vsdip/avsddac_3v3_sky130_v2/README.md

# 10Bit_potentiometric_DAC

This repository presents the design of a 10 Bit Potentiometric Digital to Analog Converter with 3.3V analog voltage, 1.8V digital voltage and 1 off-chip external reference using the sky130 technology.The specifications of the design can be found [here](https://github.com/neethujohny/avsddac_3v3/files/5164067/pdac_IP.pdf).

## Table of Contents ##

- [1. Introduction](#introduction)
- [2. Pre Layout Simulations](#pre-layout-simulations)
  * [Switch](#switch)
  * [2 bit DAC](#2-bit-dac)
  * [3 bit DAC](#3-bit-dac)
  * [4 bit DAC](#4-bit-dac)
  * [5 bit DAC](#5-bit-dac)
  * [6 bit DAC](#6-bit-dac)
  * [7 bit DAC](#7-bit-dac)
  * [8 bit DAC](#8-bit-dac)
  * [9 bit DAC](#9-bit-dac)
  * [10 bit DAC](#10-bit-dac)
- [3. Observation](#observation)
- [4. Steps to install the tools and execute the pre layout design](#steps-to-install-the-tools-and-execute-the-pre-layout-design) 
- [5. Layout](#layout)
  * [2bit DAC](#2bit-dac)
  * [3bit DAC](#3bit-dac)
  * [4bit DAC](#4bit-dac)
  * [5bit DAC](#5bit-dac)
  * [6bit DAC](#6bit-dac)
  * [7bit DAC](#7bit-dac)
  * [8bit DAC](#8bit-dac)
  * [9bit DAC](#9bit-dac)
  * [10bit DAC](#10bit-dac)
- [6. Executing the postlayout design simulations](#executing-the-postlayout-design-simulations)
- [7. Further Work](#further-work)
- [8. Contributors](#contributors)
- [9. Acknowledgements](#acknowledgements)

# Introduction

Most of the signals around us, in the world we live in are not digital in nature, rather they are analog. The digital systems can understand only digital signals, not analog. Hence, it becomes important to interface the digital systems we the external analog world. The analog input signals are to be converted to digital signals using Analog to Digital Converters at the input end of the digital system. After the processing by the system, the digital signals are to be converted back into analog signals using Digital to Analog Converters. 

A n-bit Digital to Analog Converter (DAC) takes a n-bit digital word and converts it into a proportional analog voltage with respect to the reference voltage. The potentiometric DAC uses the concept of Voltage Divider. In an N-bit DAC, the analog voltage range, i.e. the Vref (here 3.3 V) is equally divided into 2^N voltage values. This is achieved by a series on 2^N equal resistors and taps are provided across each R. The combination of switches to tap the values is designed using the N-bit digital word as input. An example of N-bit potentiometric DAC is shown in the figure below.

generalDAC

The switches are designed as shown in the figure below. The digital voltage of 1.8V or 0V is given at the digital input port for logic 1 and 0 respectively. If the digital input is logic 1, then Vin1 appears at the output port, else Vin2 appears at the output. Hence this switch circuit replaces two switches in same level as it takes into account both the swiches of complemented and uncomplemented bit.

switch circuit

These designs are used for pre layout simulations.

The block diagram of the required 10bit DAC is as shown below:

DAC design

Parameter|	Description	            |Min |	Type	|Max      	|Unit  |	Condition
---------|-------------------------|----|------|----------|------|------------
RL	      |Load resistance	         |50		|      |          |	Mohm	|T=-40 to 85C
CL	      |Load capacitance		       |    |      |	1	       |pF  	 |T=-40 to 85C
VDDA     |Analog supply		          |    | 3.3		|          |V     |T=-40 to 85C
VDD	     |Digital supply voltage		 |    |1.8		 |          |V   	 |T=-40 to 85C
VREFH	   |Reference voltage high			|    |      |3.3      	|V	    |T=-40 to 85C
VREFL	   |Reference voltage low	   |0			|      |          |V 	   |T=-40 to 85C
RES	     |Resolution		             |    |10		  |          |bit	  |T=27C
VFS	     |Full Scale Voltage	      |0		 |      |3.291627	 |V	    |T=27C

Name	| Pin No.	|I/O	|Description
-----|---------|----|------------
D [0:9]	|1-10	|I	|Digital inputs
EN	|11	|I	|Enable pin
VDD	|12	|I	|Digital power supply (1.8)
VSS	|13	|I	|Digital ground
OUT	|14	|O |DAC analog voltage output
VDDA	|15	|I	|Analog voltage supply (3.3)
VSSA	|16	|I	|Analog ground
VREFH	|17	|I	|Reference voltage high for DAC(3.3)
VREFL	|18	|I	|Reference voltage low for DAC

# Pre Layout Simulations

The tools used for these simulations are:
* eSim
* ngspice

The schematics for a switch circuit and a 2 bit DAC were designed in eSim. As the analog input voltage was 3.3V, the vdd and vref was set to 3.3V. For the voltage divider circuit, a series of 4 resistors of 250ohm each were used. 

## Switch
The switch circuit mentioned above was designed using eSim. The screenshots of the schematic are as shown below:

switch

The result of transient analysis of the switch is shown below:

switch op

The file switchfinal.spice was used.
Here, in the spice file, the higher reference voltage was set to 2.5V and the lower reference voltage was set to 2.2V just for the purpose of verifying the circuit. Here it can be observed that when the digital input for the switch is high (1.8V), the higher reference voltage appears at the output; when the digital input for the switch is low(0V), the lower reference voltage appears at the output. So, it was concluded that the switch circuit is working properly.

## 2 bit DAC
For the 2 bit DAC, switch circuit was included as a subcircuit. After creating the schematics, the spice netlist was extracted. The necessary model files of sky130 tt transistors were included in the netlist and transient analysis was performed.

The schematic of 2 bit DAC is as shown below: 

2bitDAC

The result of the transient analysis of the 2bit DAC is shown below:

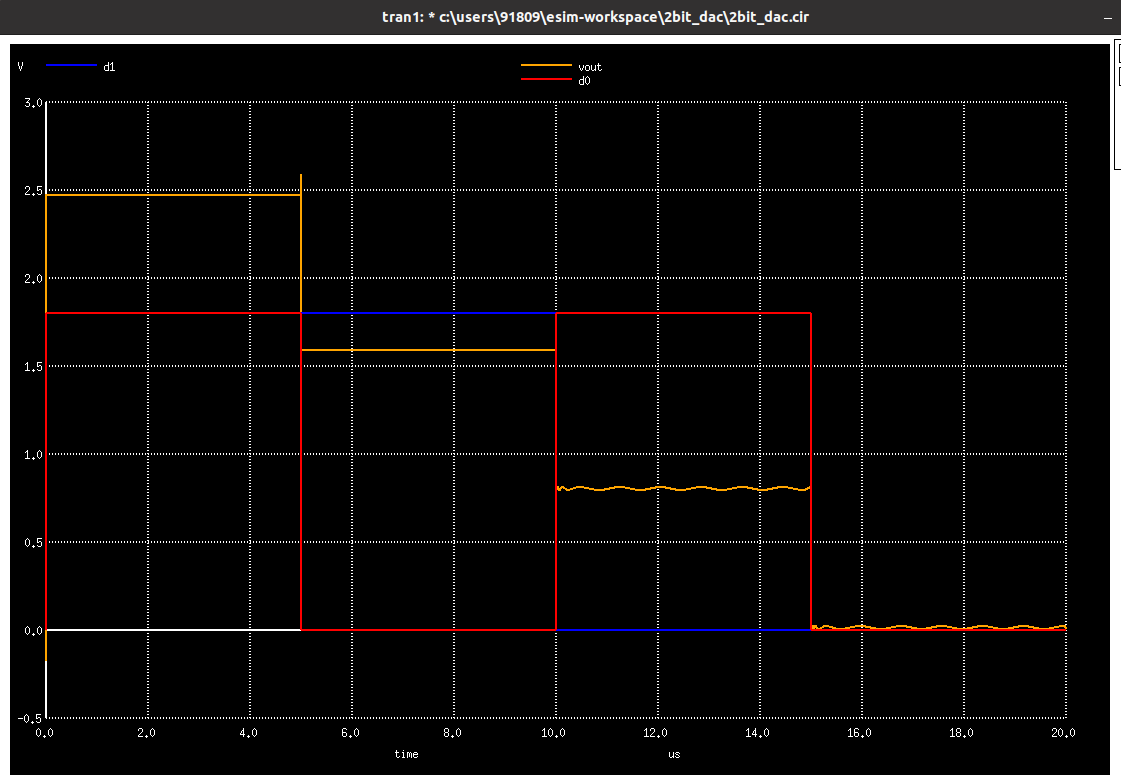
[picture p1: DAC_Prelayout/Screenshots/2bitDAC_op.png]
2bit dac op


The spice file 2bitDAC.spice was used.
The two bit digital inputs were given as 11, 10, 01 and 00. It can be observed that when the inputs are 1 1, 2.47V appears at the output. When the inputs are 1 0, 1.57 V appears at the output. Similarly, for the inputs 0 1 and 0 0, 0.76V and 0 V appear at output respectively. Thus, the 2 bit digital input is converted to corresponding analog values with reference voltage of 3.3 V. 

## 3 bit DAC
For the 3 bit DAC, the subcircuits 2bit_DAC.sub and switch.sub were used. The schematic is as shown below:

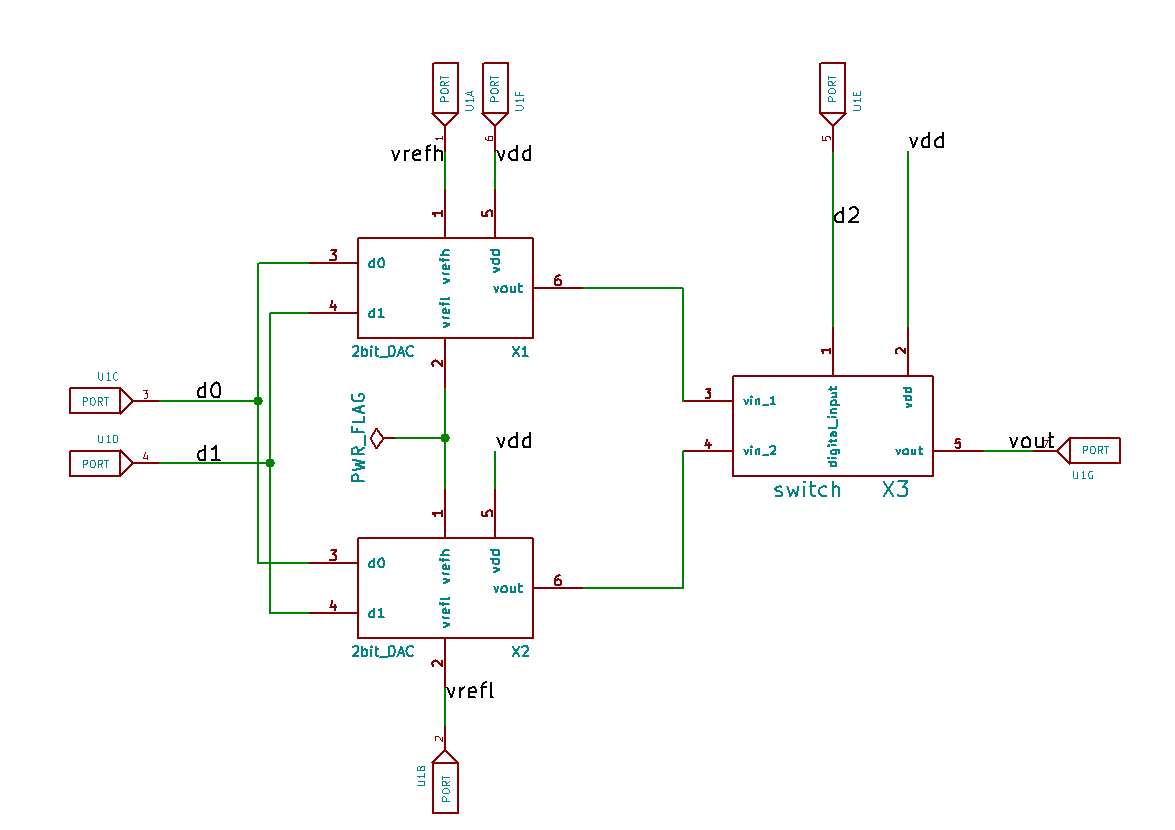
[picture p2: DAC_Prelayout/Screenshots/3bitDAC.png]
3bitDAC


The result of transient analysis of 3 bit DAC is shown below:

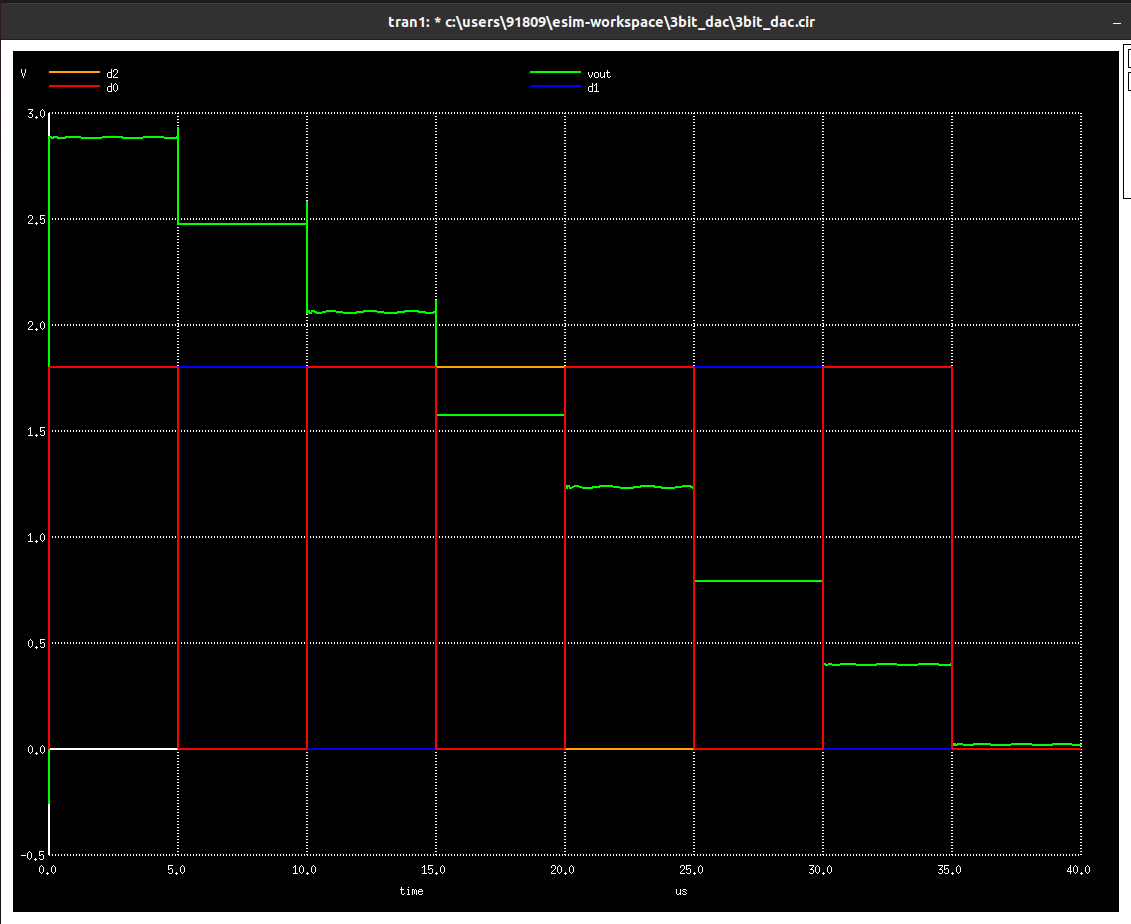
[picture p3: DAC_Prelayout/Screenshots/3bitDAC_op.png]
3bit dac op


Here, there are 3 digital input bits and hence 8 steps in the analog output.

The subcircuit of 3bit DAC was created which included the 2bit DAC and switch subcircuits.

## 4 bit DAC
For the 4 bit DAC, the subcircuits 3bit_DAC.sub and switch.sub were used. The eSim schematic is as shown below:

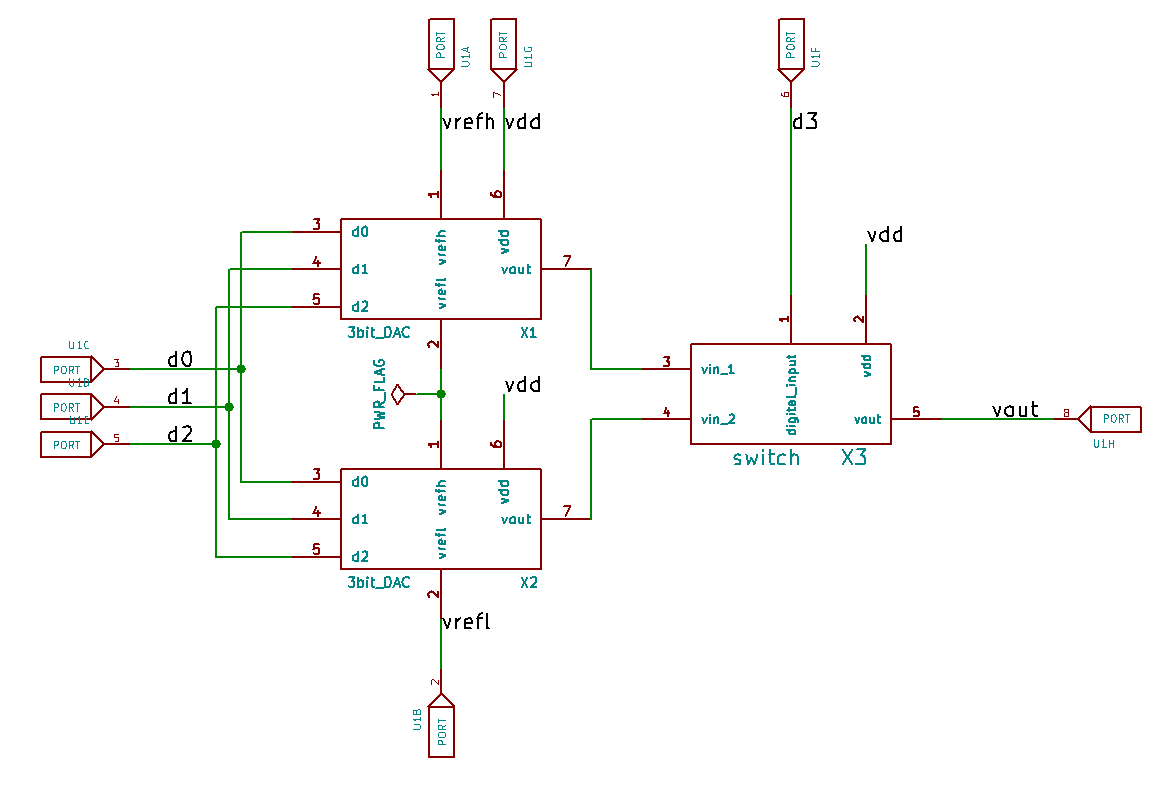
[picture p4: DAC_Prelayout/Screenshots/4bitDAC.png]
4bitDAC


The result of the transient analysis of the circuit is shown below:

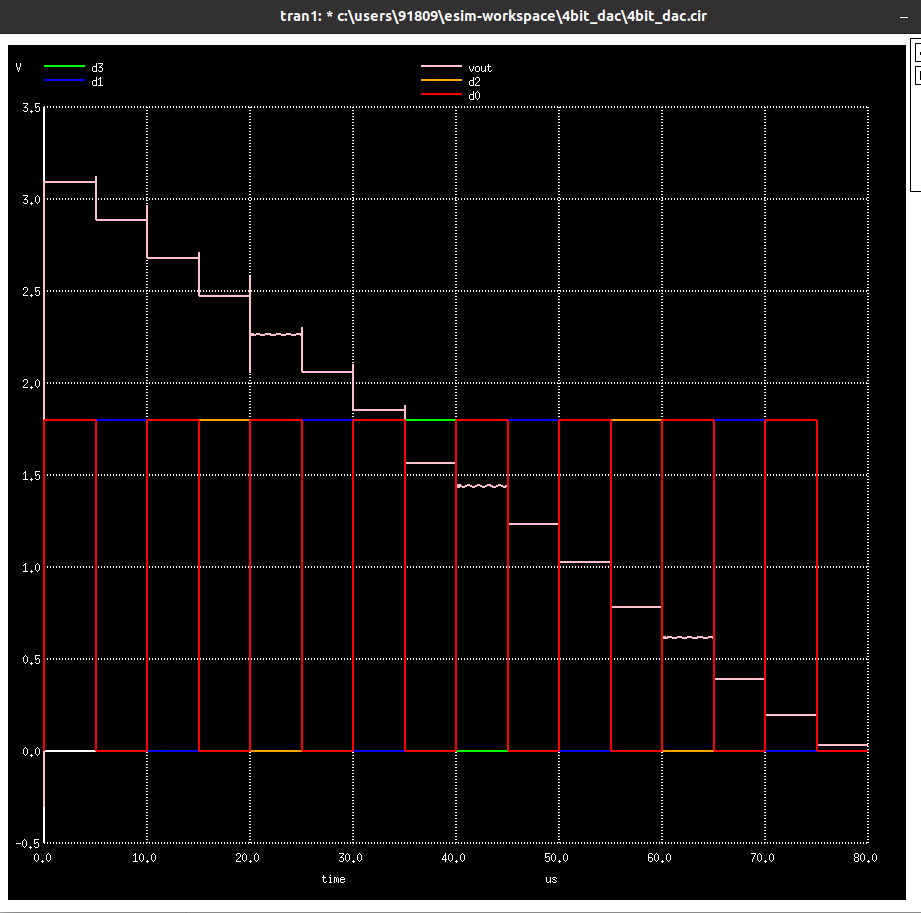
[picture p5: DAC_Prelayout/Screenshots/4bitDAC_op.png]
4bit dac op


Here, there are 4 digital input bits and hence 16 steps in the analog output.

The subcircuit of 4 bit DAC was created which included 3bit DAC and switch.

## 5 bit DAC
For the 5 bit DAC, the subcircuits 4bit_DAC.sub and switch.sub were used. The eSim schematic is as shown below:

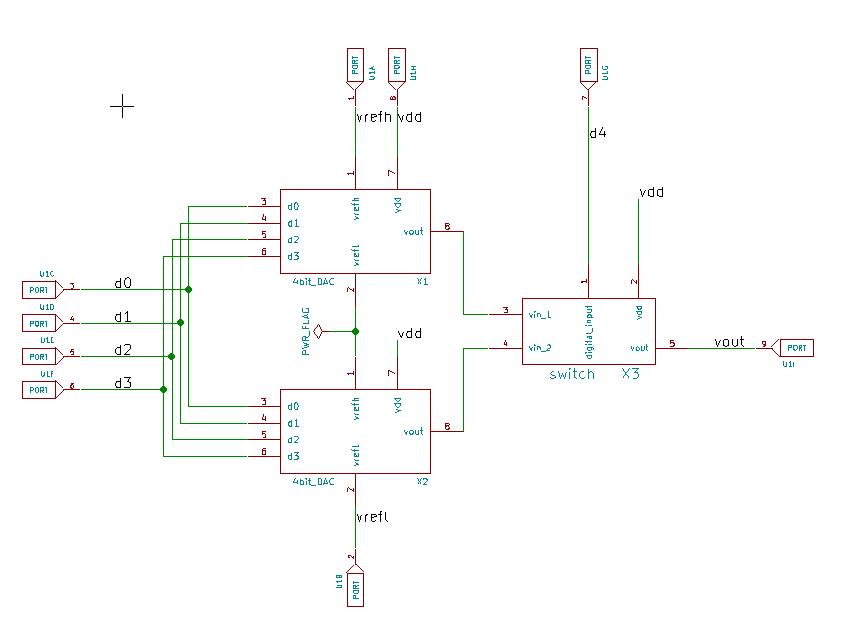
[picture p6: DAC_Prelayout/Screenshots/5bitDAC.png]
5bitDAC


The result of the transient analysis of the circuit is shown below:

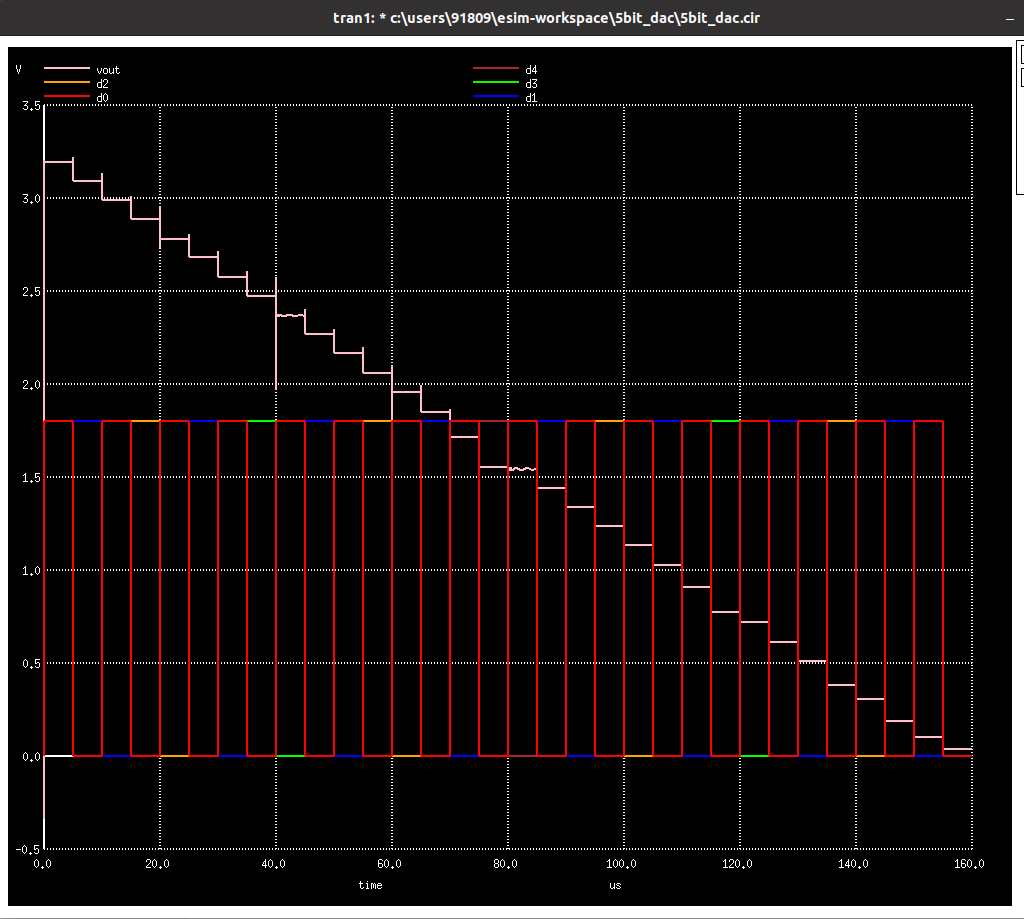
[picture p7: DAC_Prelayout/Screenshots/5bitDAC_op.png]
5bit dac op


Here, there are 5 digital input bits and hence 32 steps in the analog output.

The subcircuit of 5 bit DAC was created which included 4bit DAC and switch.

## 6 bit DAC
For the 6 bit DAC, the subcircuits 5bit_DAC.sub and switch.sub were used. The eSim schematic is as shown below:

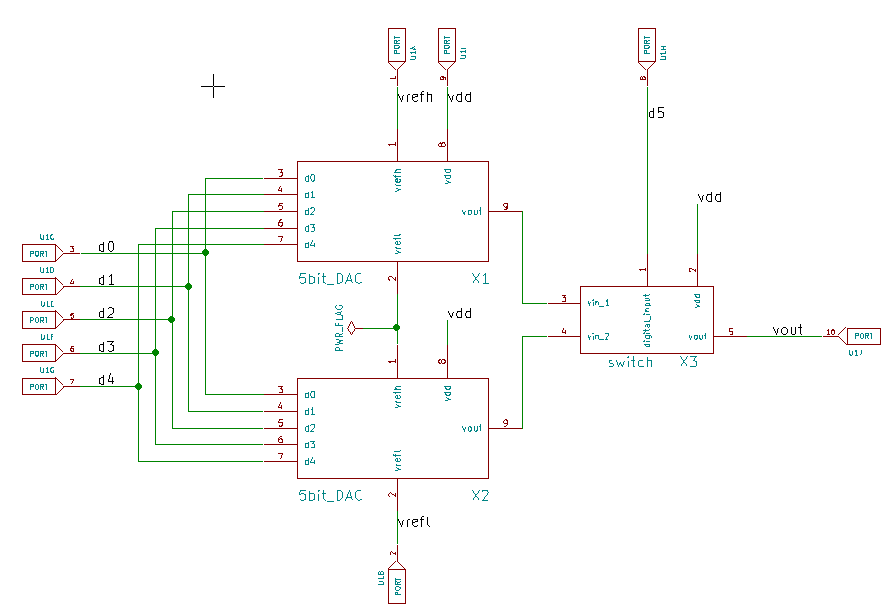
[picture p8: DAC_Prelayout/Screenshots/6bitDAC.png]
6bitDAC


The result of the transient analysis of the circuit is shown below:

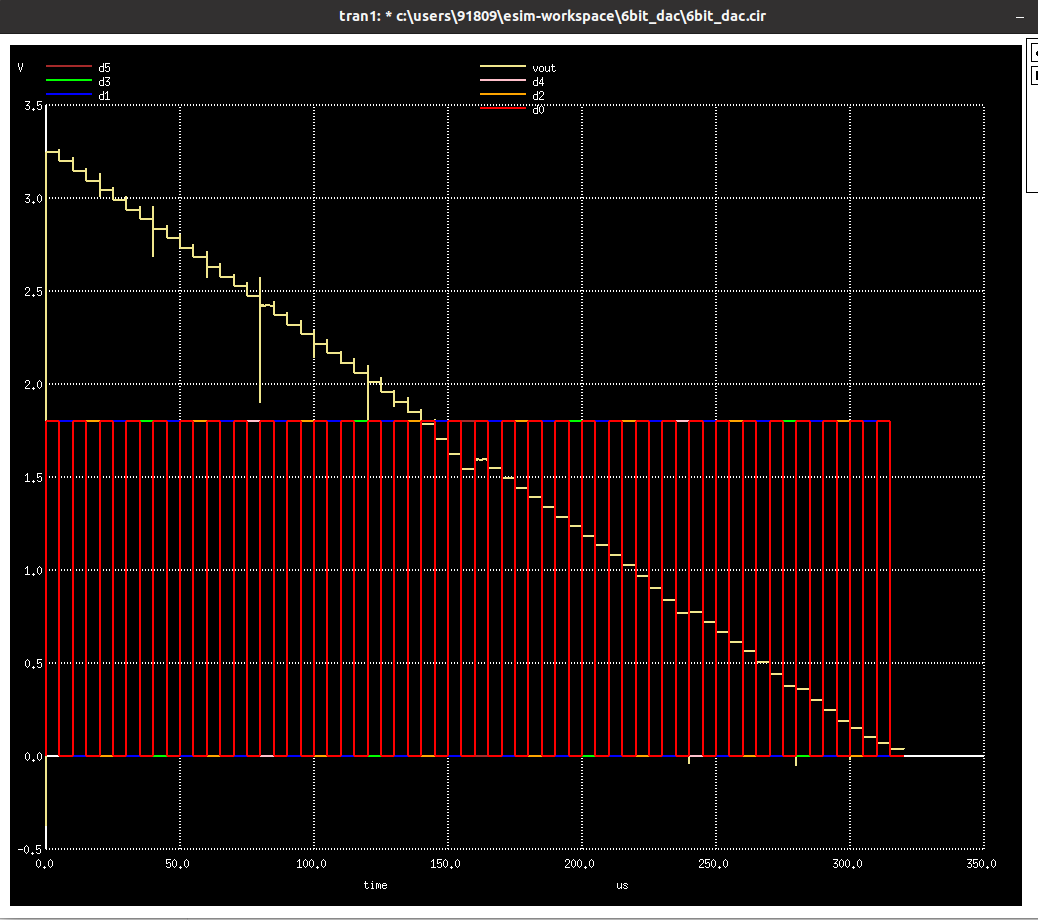
[picture p9: DAC_Prelayout/Screenshots/6bitDAC_op.png]
6bit dac op


Here, there are 6 digital input bits and hence 64 steps in the analog output.

The subcircuit of 6 bit DAC was created which included 5bit DAC and switch.

## 7 bit DAC
For the 7 bit DAC, the subcircuits 6bit_DAC.sub and switch.sub were used. The eSim schematic is as shown below:

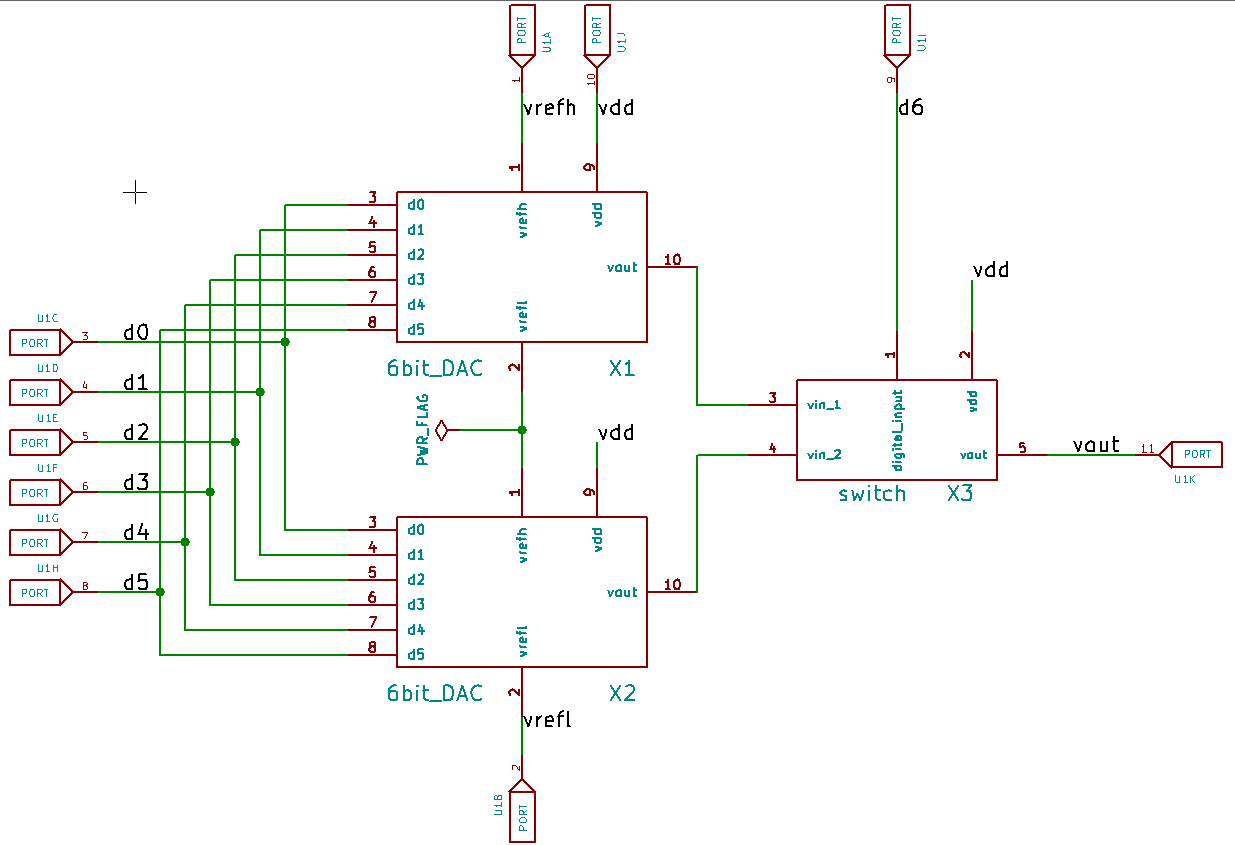
[picture p10: DAC_Prelayout/Screenshots/7bitDAC.png]
7bitDAC


The result of the transient analysis of the circuit is shown below:

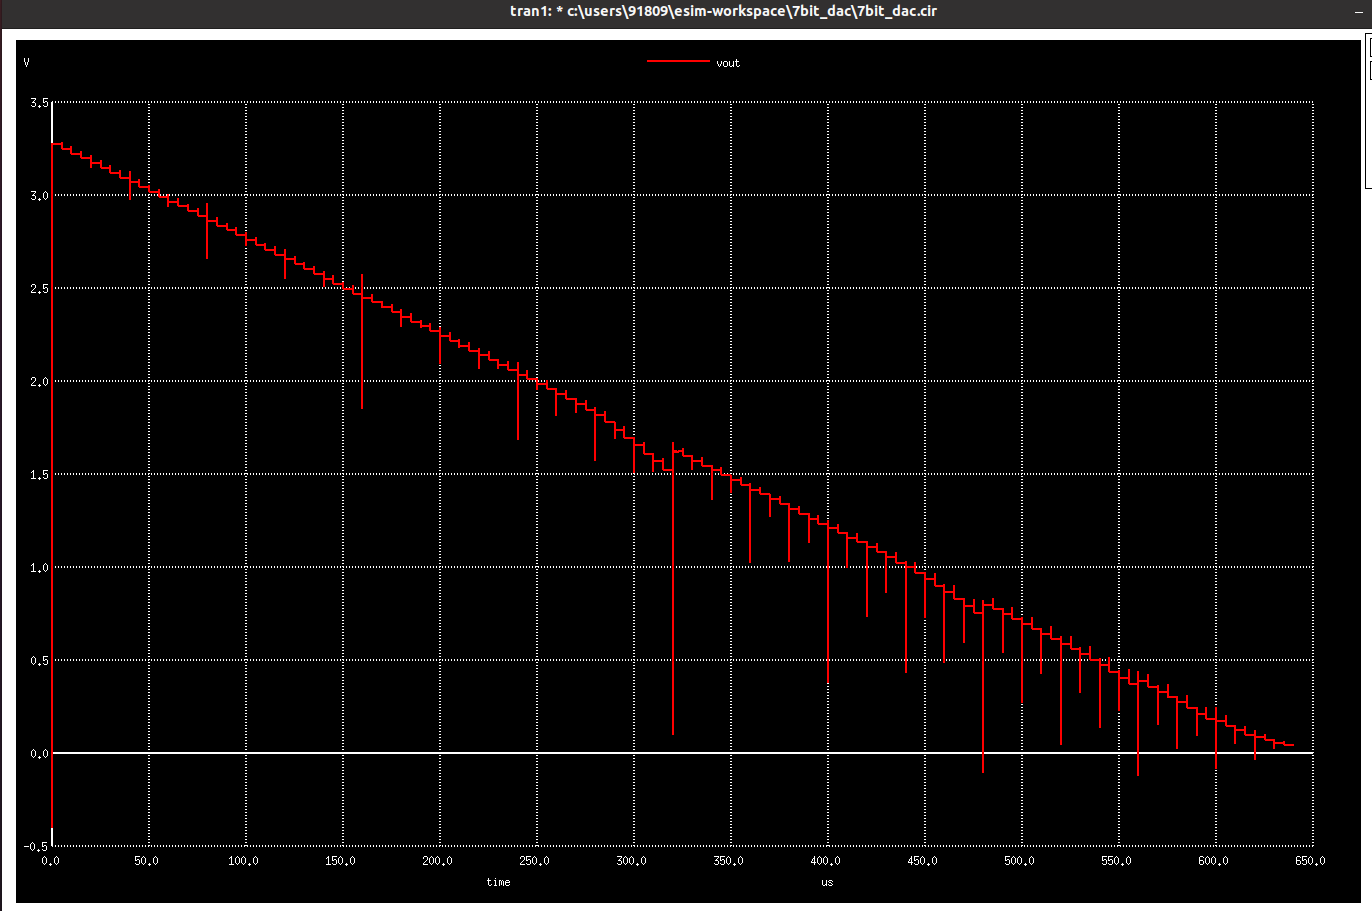
[picture p11: DAC_Prelayout/Screenshots/7bitDAC_op.png]
7bit dac op


Here, there are 7 digital input bits and hence 128 steps in the analog output.

The subcircuit of 7 bit DAC was created which included 6bit DAC and switch.

## 8 bit DAC
For the 8 bit DAC, the subcircuits 7bit_DAC.sub and switch.sub were used. The eSim schematic is as shown below:

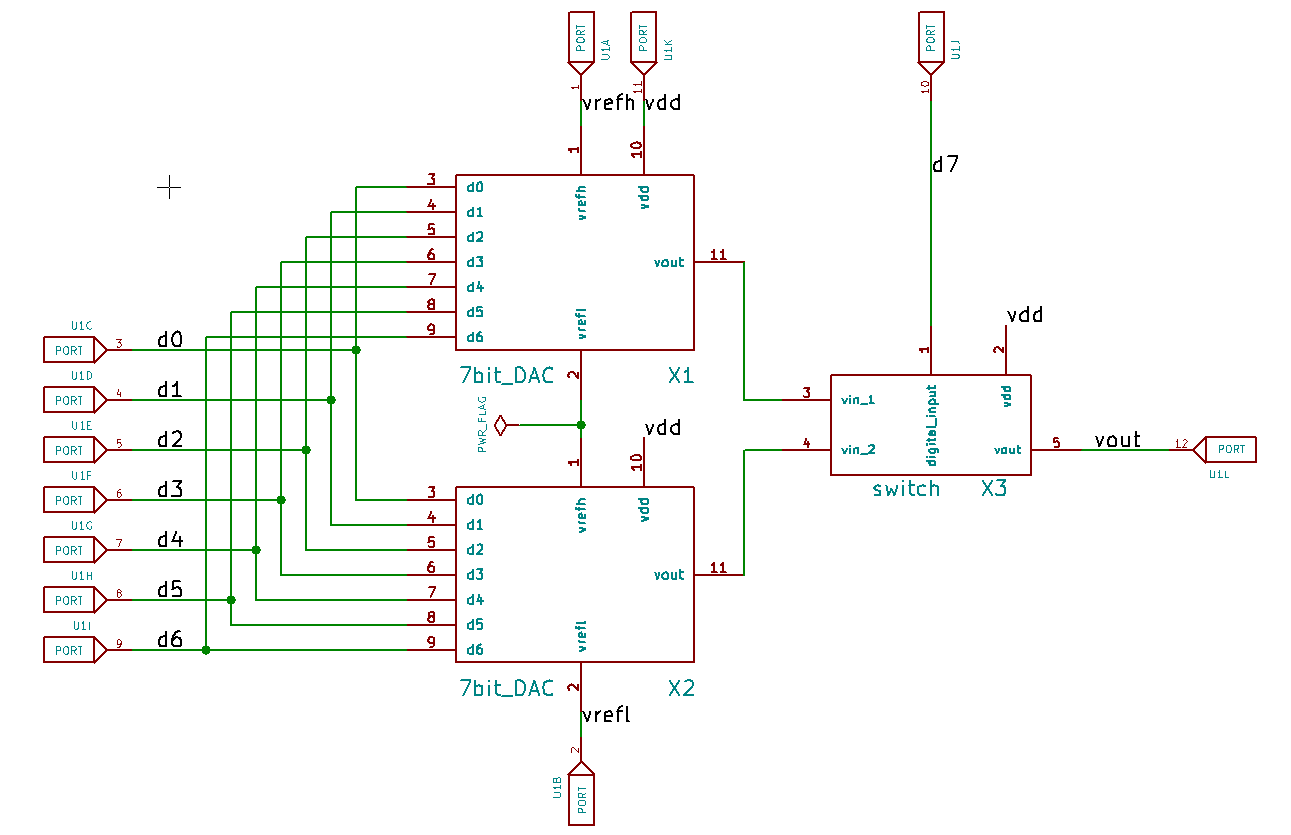
[picture p12: DAC_Prelayout/Screenshots/8bitDAC.png]
8bitDAC


Here, there are 8 digital input bits and hence 256 steps in the analog output.

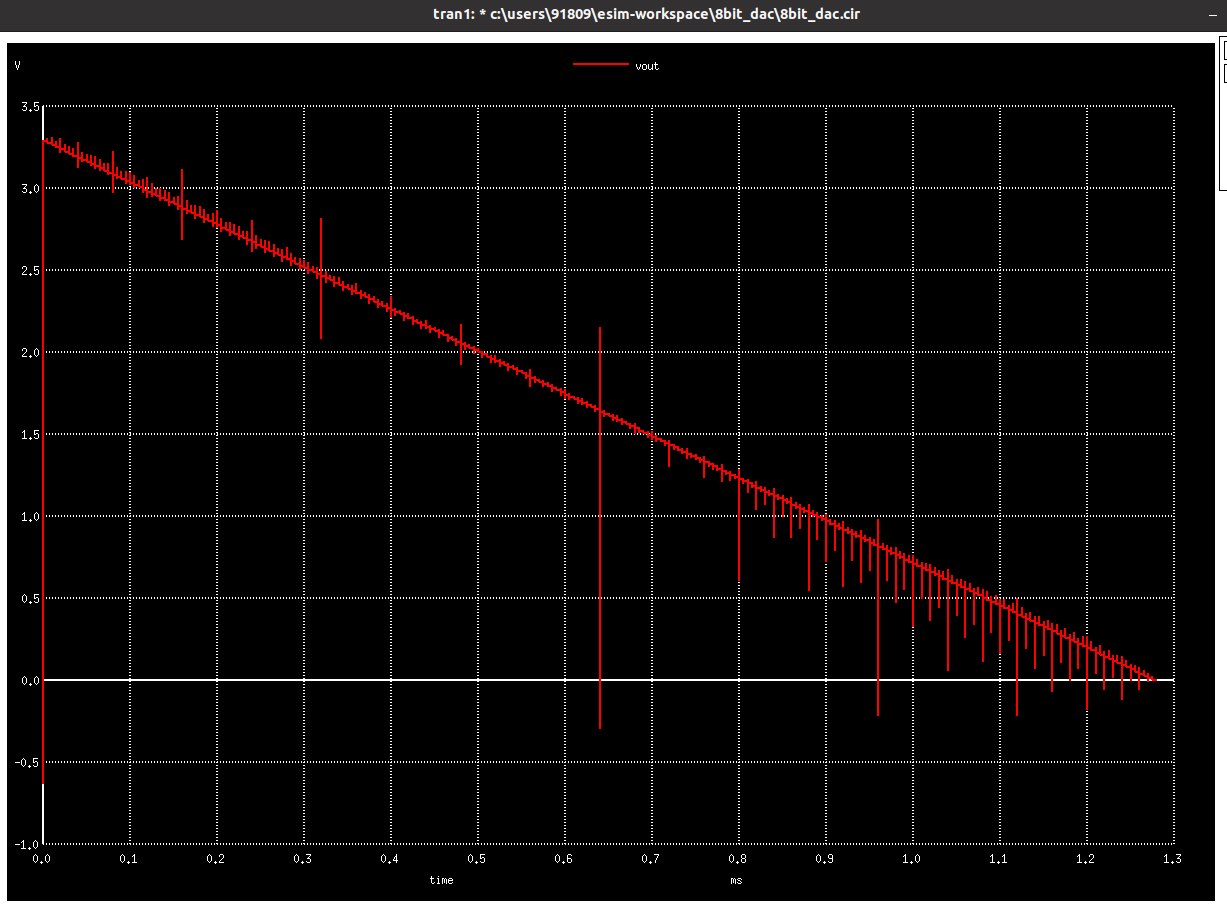
[picture p13: DAC_Prelayout/Screenshots/8bitDAC_op.png]
8bit dac op


The subcircuit of 8 bit DAC was created which included 7bit DAC and switch.

## 9 bit DAC
For the 9 bit DAC, the subcircuits 8bit_DAC.sub and switch.sub were used. The eSim schematic is as shown below:

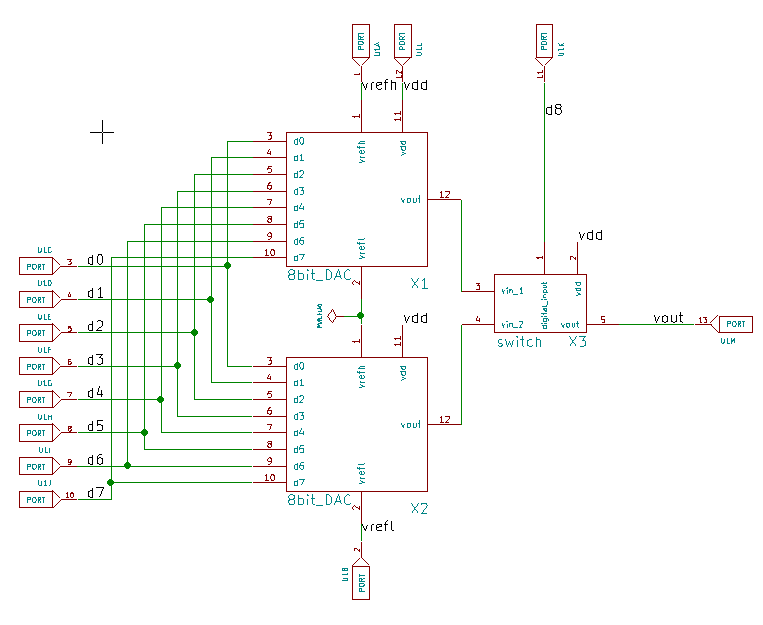
[picture p14: DAC_Prelayout/Screenshots/9bitDAC.png]
9bitDAC


The transient response of this schematic could not be obtained. The ngspice session got killed.

However, the subcircuit of 9 bit DAC was created which included 8bit DAC and switch.

## 10 bit DAC
For the 10 bit DAC, the subcircuits 9bit_DAC.sub and switch.sub were used. The eSim schematic is as shown below:

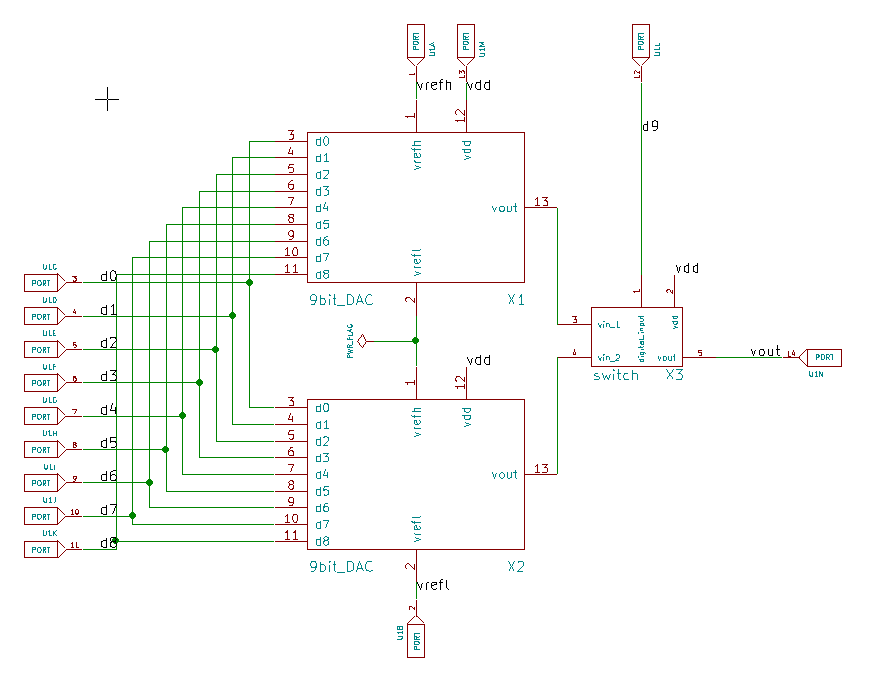
[picture p15: DAC_Prelayout/Screenshots/10bitDAC.png]
10bitDAC


The transient response of this schematic is as shown below:

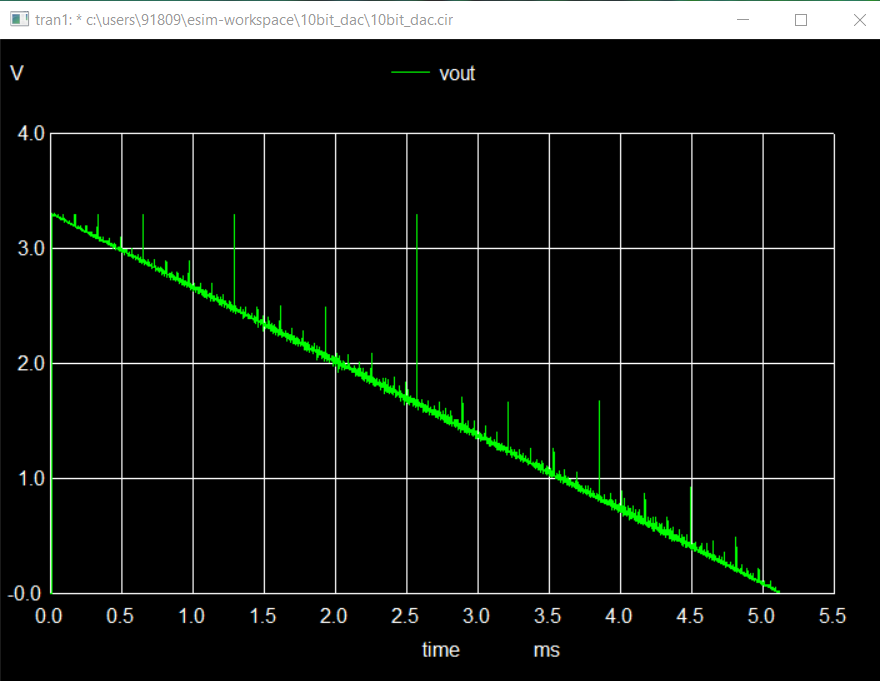
[picture p16: DAC_Prelayout/Screenshots/10bit_DAC_output.png]


# Observation

It was observed that with increase in the resolution of DAC, the number of steps were increased, the stepsize reduced leading to a smoother step waveform.

# Steps to install the tools and execute the pre layout design
## Steps to install eSim
1. Install the eSim tool using this [website](https://esim.fossee.in/downloads). Note: You can also refer to the eSim [Spoken Tutorial](https://spoken-tutorial.org/tutorial-search/?search_foss=eSim).
2.  The subcircuits of lower DACs is present in the [subcircuits](https://github.com/SameerSDurgoji/10Bit_potentiometric_DAC/tree/main/subcircuits) folder. Copy its contents to the eSim subcircuit library (C:\FOSSEE\eSim\library\SubcircuitLibrary) in order to use the subcircuits in the schematic.

## Executing the prelayout design simulations

1. Clone this repository using the commands:
```
$ sudo apt install -y git
$ git clone https://github.com/vsdip/avsddac_3v3_sky130_v2.git
```

2. Change diectory to avsddac_3v3_sky130_v2 by typing ```$ cd avsddac_3v3_sky130_v2```

3. Got to the respective DAC folder by using the command ```$ cd nbit_DAC/```

4. To run the schematic, run the command:
```
$ ngspice <nbit_DAC1.cir.out>
```

The simulations of higher bit DACs consume more time. 

# Layout

The layout of these circuits is to be drawn in magic using sky130 tech file. 

## Resistor

The layout for resistor was drawn as shown below:

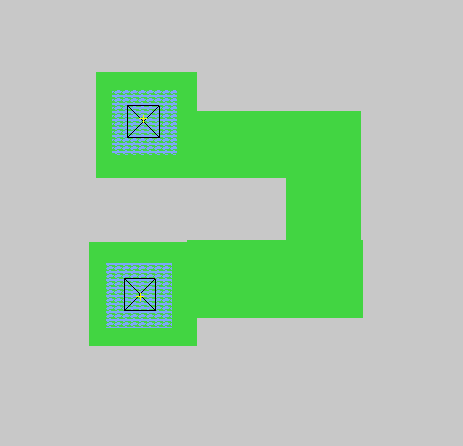
[picture p17: Screenshots/resistor.png]
resistor


The resistance of this resistor was found to be 517.89 ohm.

## Switch

The layout for switch was drawn as shown below:

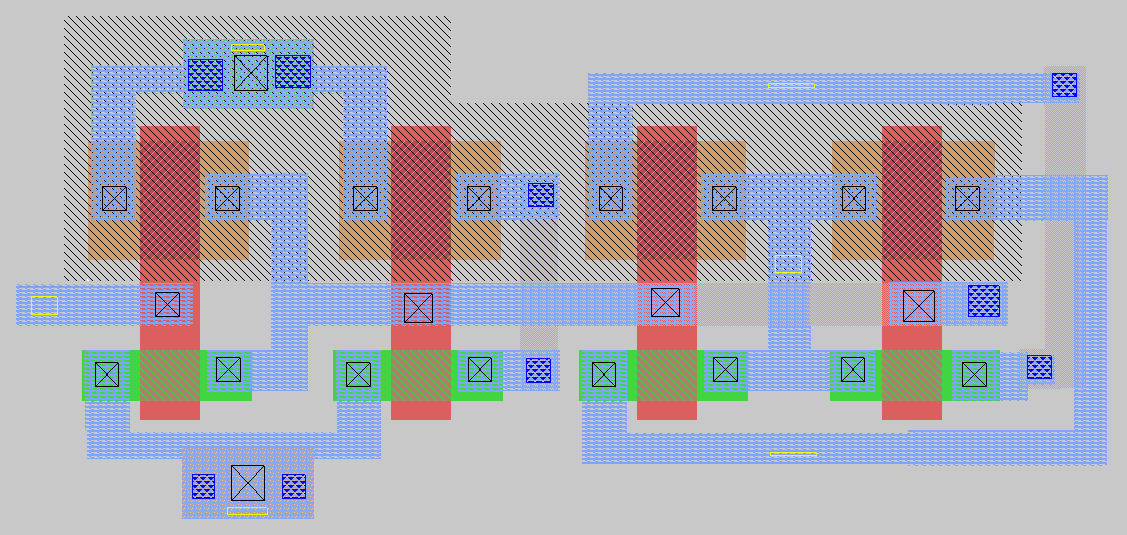
[picture p18: Screenshots/switch.png]
switch layout


## 2bit DAC

The layout for 2bit DAC was drawn as shown below:

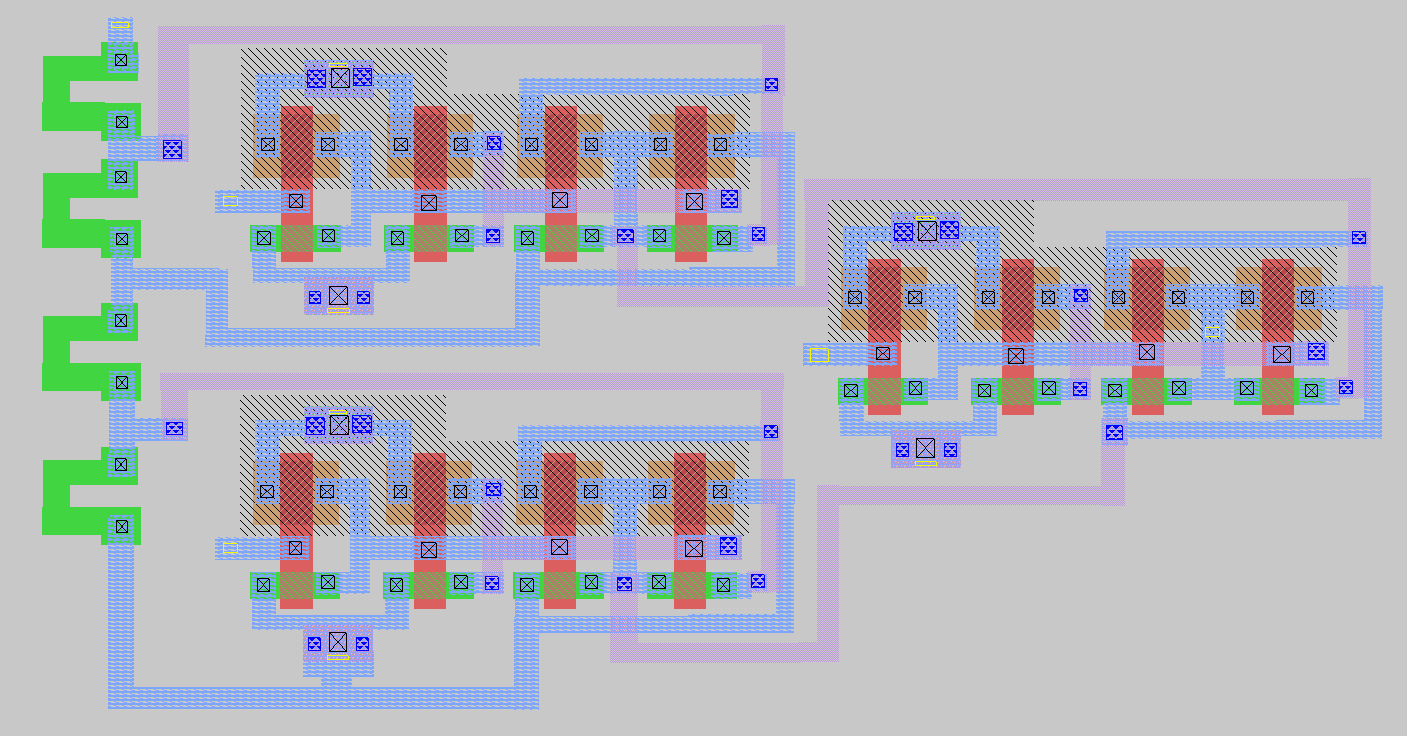
[picture p19: Screenshots/2bit_DAC.png]
2bitDAC layout


The spice file was extracted and the output was observed as shown below:

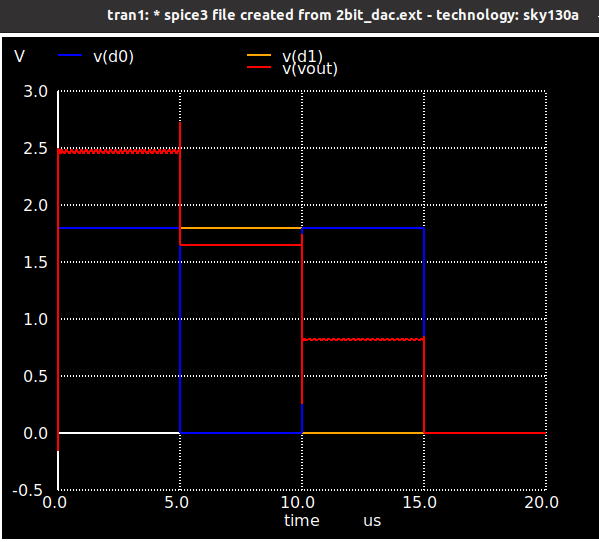
[picture p20: Screenshots/2bit_output.png]
2bitDAC sim


## 3bit DAC

The layout for 3bit DAC was drawn as shown below:

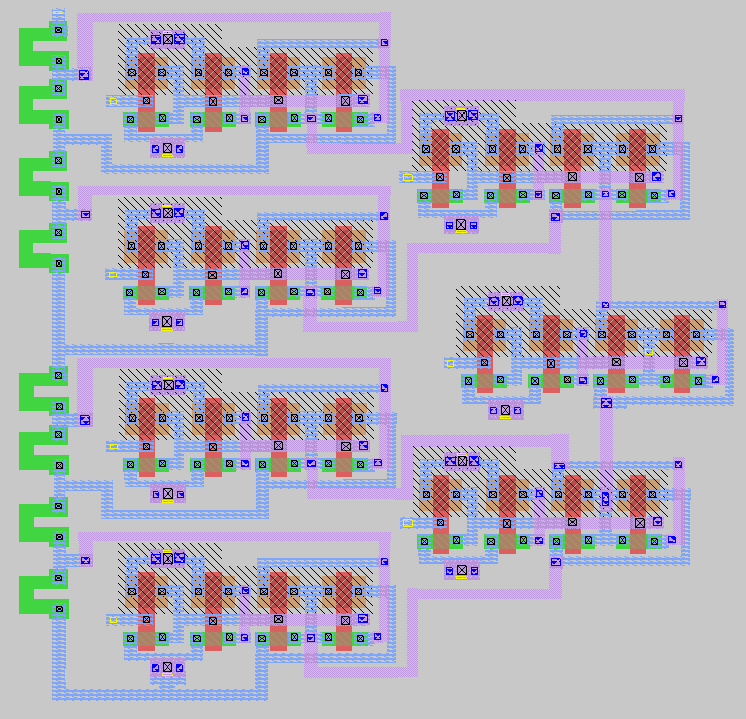
[picture p21: Screenshots/3bit_DAC.png]
3bitDAC layout


The spice file was extracted and the output was observed as shown below:

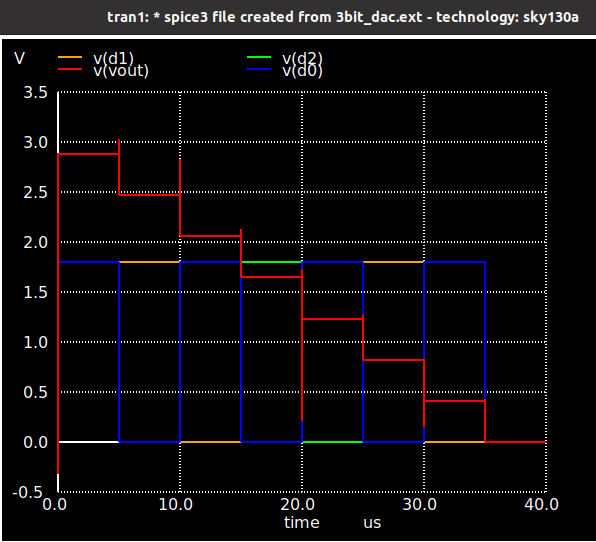
[picture p22: Screenshots/3bit_output.png]
3bitDAC sim


## 4bit DAC

The layout for 4bit DAC was drawn as shown below:

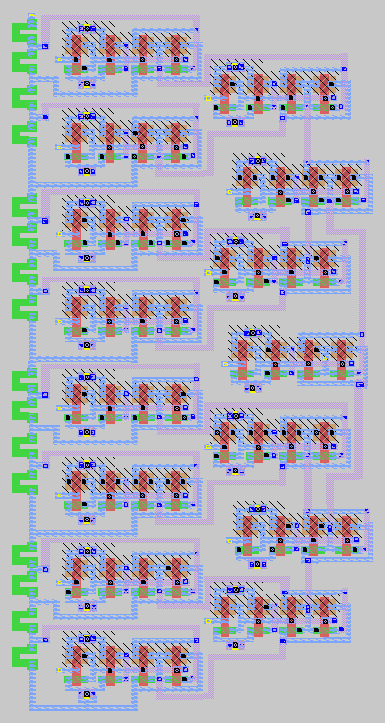
[picture p23: Screenshots/4bit_DAC.png]
4bitDAC layout


The spice file was extracted and the output was observed as shown below:

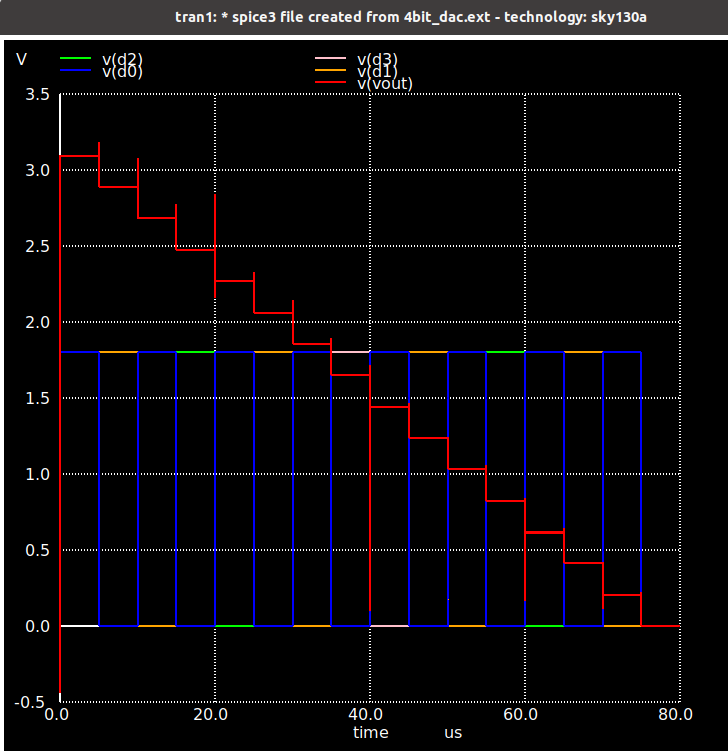
[picture p24: Screenshots/4bit_output.png]
4bitDAC sim


## 5bit DAC

The layout for 5bit DAC was drawn as shown below:

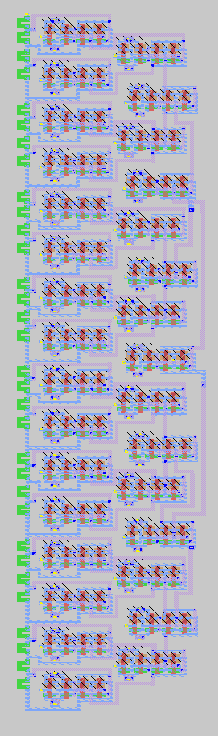
[picture p25: Screenshots/5bit_DAC.png]
5bitDAC layout


The spice file was extracted and the output was observed as shown below:

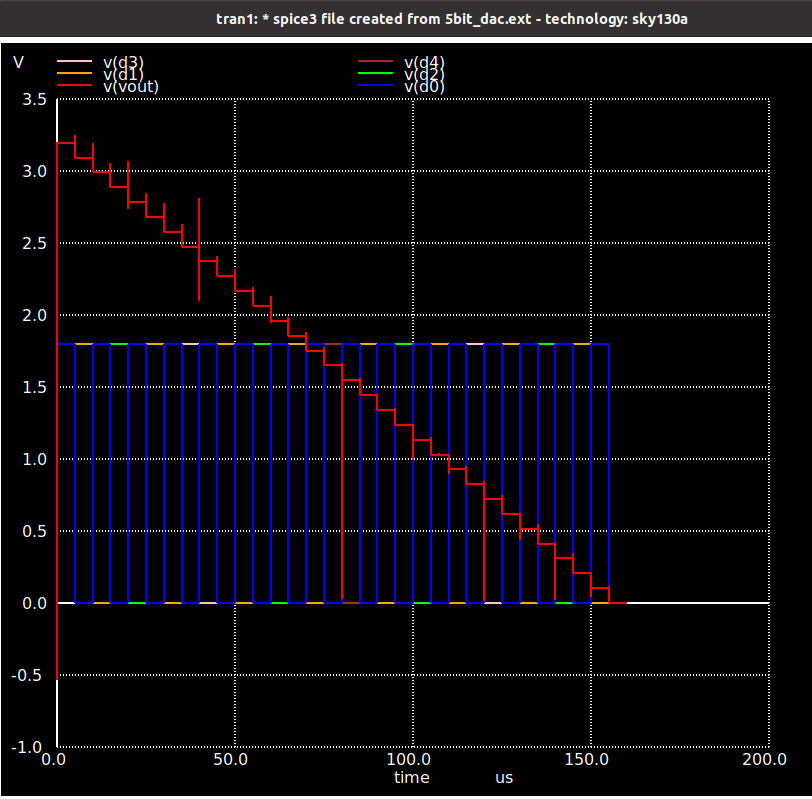
[picture p26: Screenshots/5bit_output.png]
5bitDAC sim


## 6bit DAC

The layout for 6bit DAC was drawn as shown below:

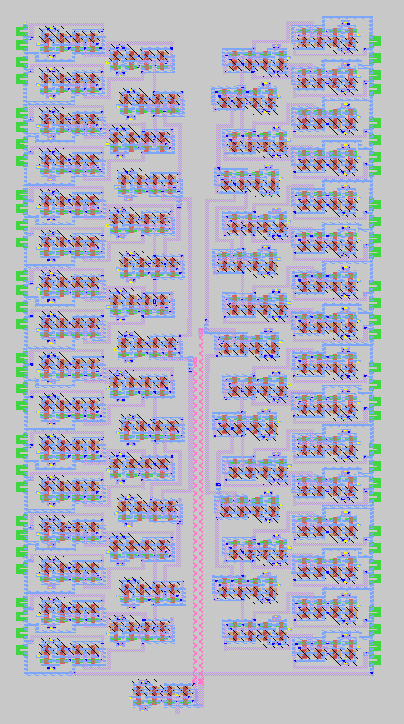
[picture p27: Screenshots/6bit_DAC.png]
6bitDAC layout


The spice file was extracted and the output was observed as shown below:

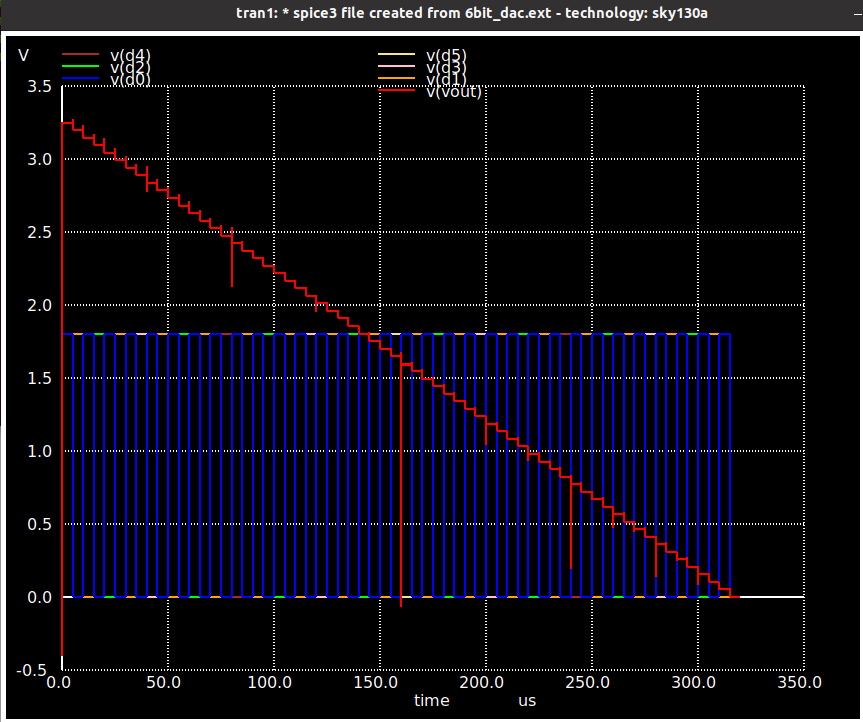
[picture p28: Screenshots/6bit_output.png]
6bitDAC sim


## 7bit DAC

The layout for 7bit DAC was drawn as shown below:

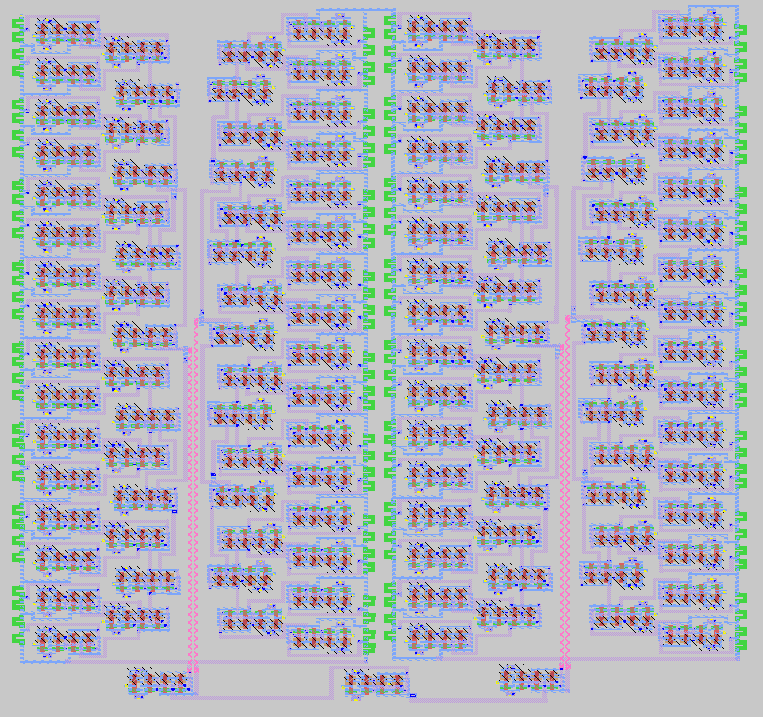
[picture p29: Screenshots/7bit_DAC.png]
7bitDAC layout


The spice file was extracted and the output was observed as shown below:

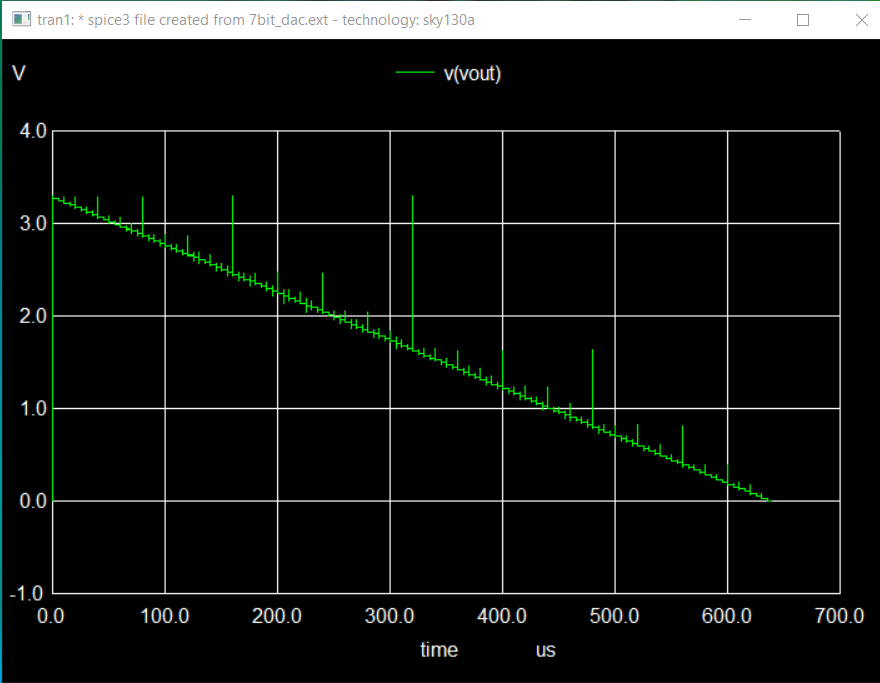
[picture p30: Screenshots/7bit_output.png]
7bitDAC sim


## 8bit DAC

The layout for 8bit DAC was drawn as shown below:

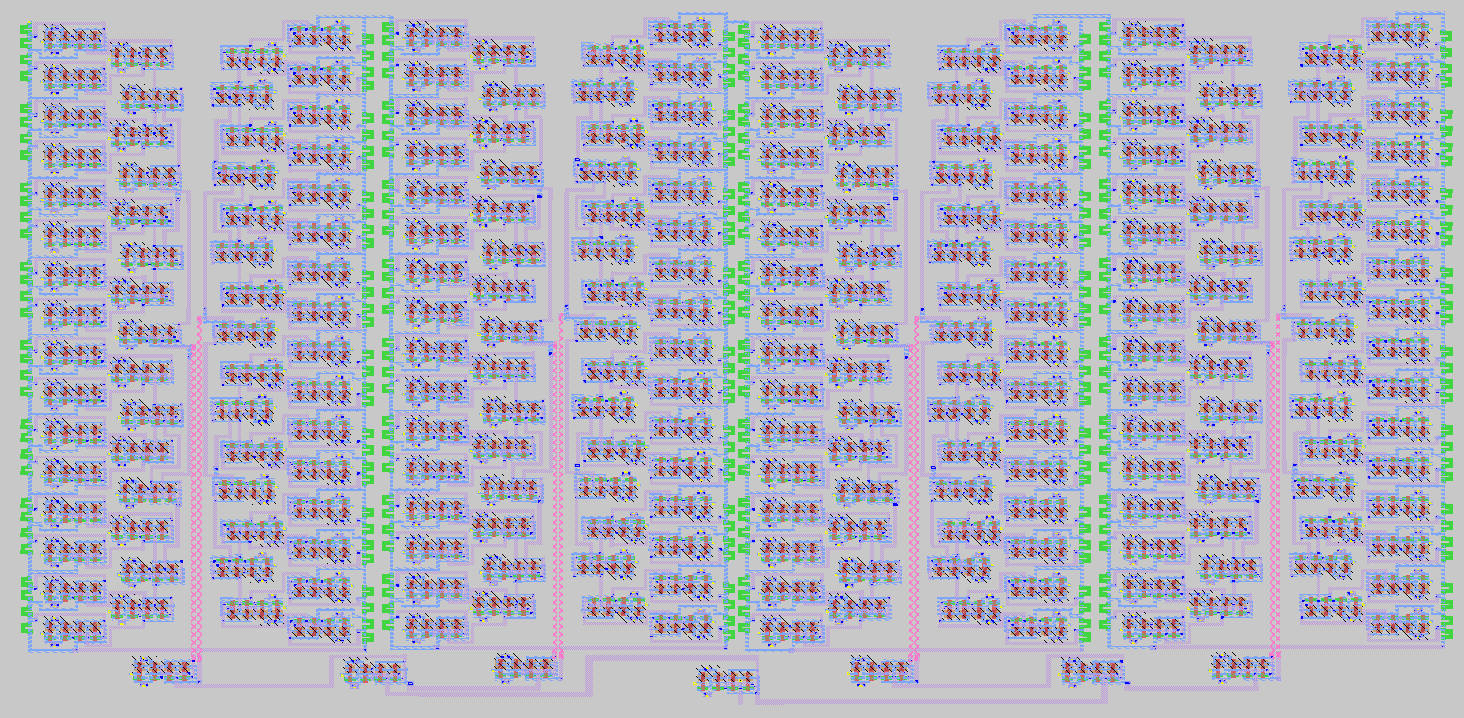
[picture p31: Screenshots/8bit_DAC.png]
8bitDAC layout


The spice file was extracted and the output was observed as shown below:

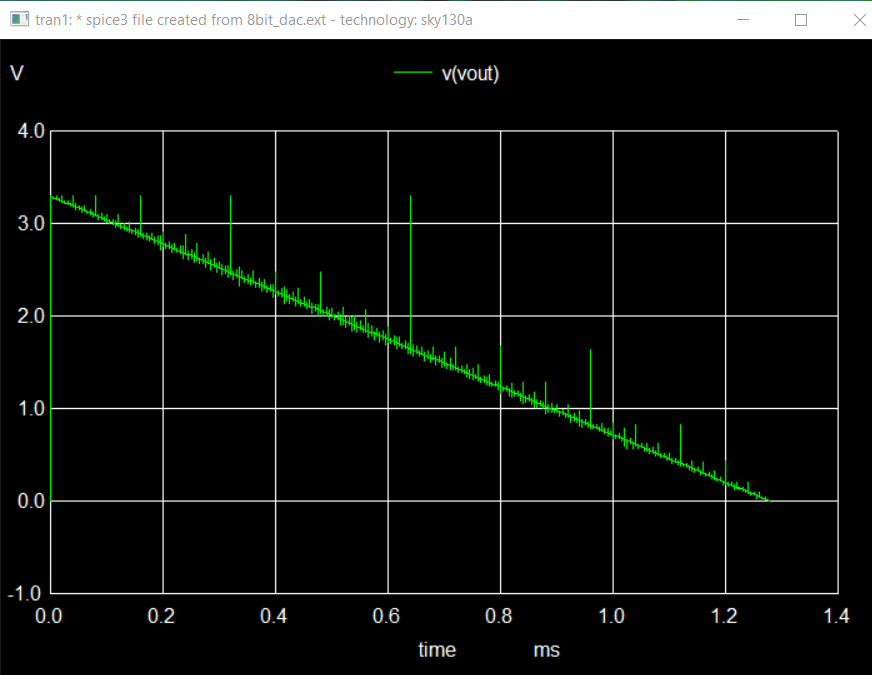
[picture p32: Screenshots/8bit_output.png]
8bitDAC sim


## 9bit DAC

The layout for 9bit DAC was drawn as shown below:

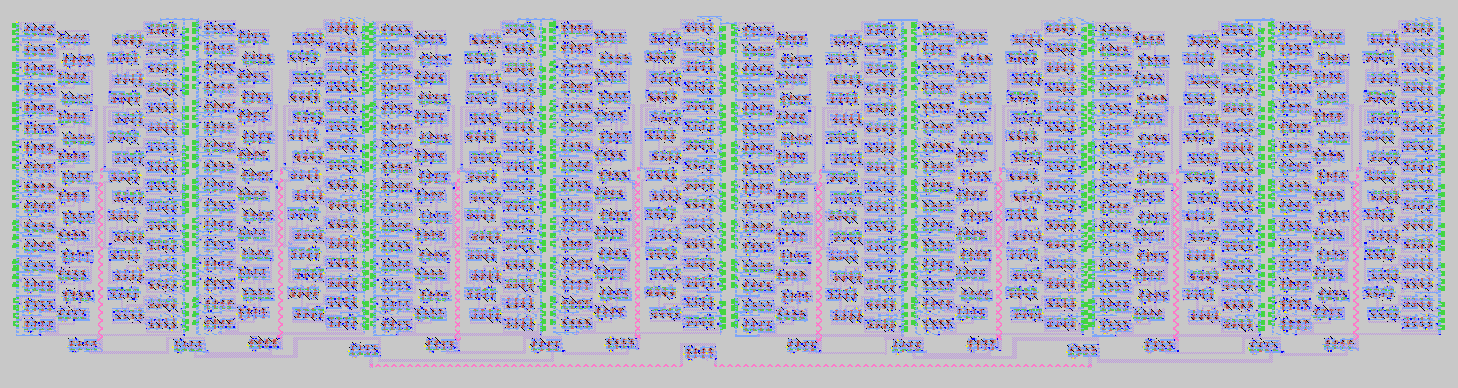
[picture p33: Screenshots/9bit_DAC.png]
9bitDAC layout


The spice file was extracted and the output was observed as shown below:
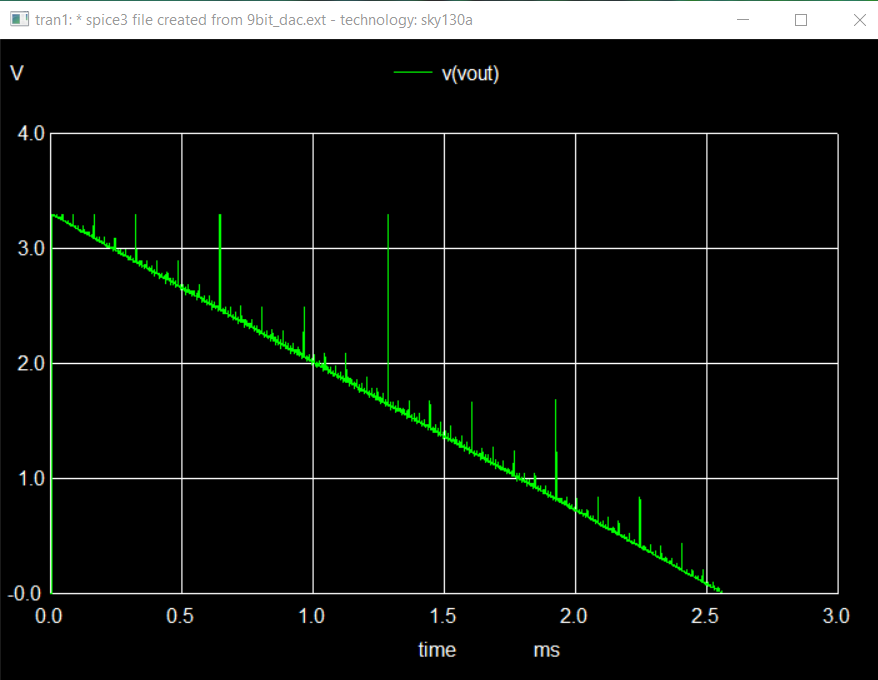
[picture p34: Screenshots/9bit_output.png]
9bitDAC_sim


## 10bit DAC

The layout for 10bit DAC was drawn as shown below:

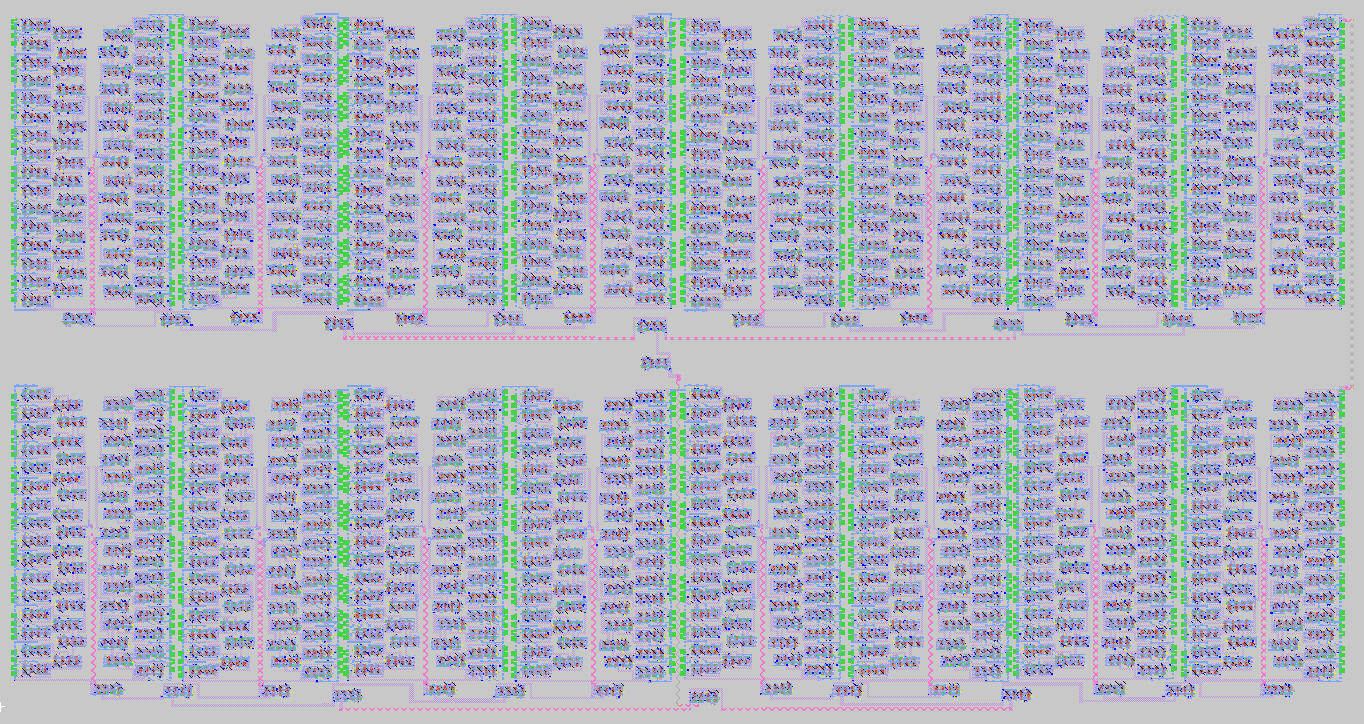
[picture p35: Screenshots/10bit_DAC.png]
10bitDAC layout


The spice file was extracted and the output was observed as shown below:
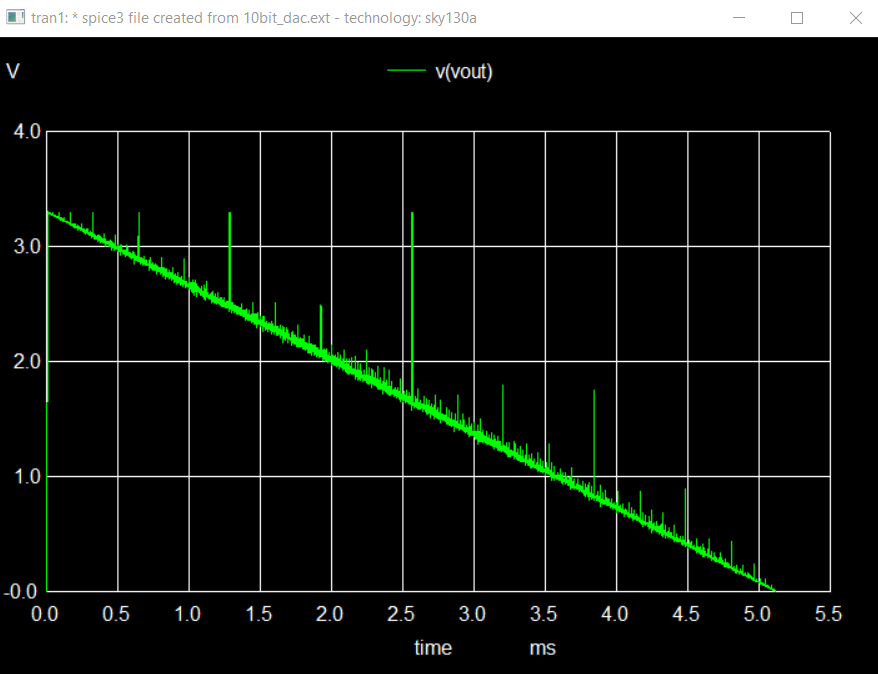
[picture p36: Screenshots/10bit_output.png]
10bitDAC_sim


## Executing the postlayout design simulations

1. Clone this repository using the commands:
```
$ sudo apt install -y git
$ git clone https://github.com/vsdip/avsddac_3v3_sky130_v2.git
```

2. Change directory to avsddac_3v3_sky130_v2 by typing ```$ cd avsddac_3v3_sky130_v2/```

3. Go to the Post Layout Simulation folder by using the command ```$ cd Post\ Layout\ Simulation/```

4. Run the command ```$ git clone https://foss-eda-tools.googlesource.com/skywater-pdk/libs/sky130_fd_pr``` to download the sky130_fd_pr folder.

5. Then, to run the spice file, run the command:
```
$ ngspice <nbit_DAC.spice>
```

The simulations of higher bit DACs consume more time. 

# Further Work

Further work would be to obtain the simulatios of 9 bit DAC and 10 bit DAC and calculate INL and DNL for 10 bit DAC.

# Contributors

* Sameer S Durgoji , B.Tech (Electronics and Communication Engineering), National Institute of Technology Karnataka - sameerdurgoji@gmail.com
* Kunal Ghosh, Co-Founder of VLSI System Design (VSD) Corp. Pvt. Ltd. - kunalghosh@gmail.com

# Acknowledgements

 * Kunal Ghosh, Co-Founder of VLSI System Design (VSD) Corp. Pvt. Ltd. - kunalghosh@gmail.com
