vsdip/avsddac_3v3_sky130_v2/Post Layout Simulations/6bit_DAC_test.spice

* SPICE3 file created from 6bit_DAC.ext - technology: sky130A

.lib "sky130_fd_pr/models/sky130.lib.spice" tt

X0 a_1726_3204# a_1513_3204# gnd gnd sky130_fd_pr__nfet_01v8 w=0.42 l=0.5
X1 a_852_7898# a_431_7898# a_116_8103# vdd sky130_fd_pr__pfet_01v8 w=1 l=0.5
X2 a_116_8333# a_645_8452# a_853_8452# vdd sky130_fd_pr__pfet_01v8 w=1 l=0.5
X3 gnd d0 a_4079_1330# gnd sky130_fd_pr__nfet_01v8 w=0.42 l=0.5
X4 a_648_177# a_435_177# vdd vdd sky130_fd_pr__pfet_01v8 w=1 l=0.5
X5 gnd d0 a_4080_227# gnd sky130_fd_pr__nfet_01v8 w=0.42 l=0.5
X6 a_2004_n382# a_2823_4353# a_2774_4543# gnd sky130_fd_pr__nfet_01v8 w=0.42 l=0.5
X7 a_3821_4829# a_4078_4639# a_2883_5073# vdd sky130_fd_pr__pfet_01v8 w=1 l=0.5
X8 gnd d1 a_3138_8192# gnd sky130_fd_pr__nfet_01v8 w=0.42 l=0.5
X9 gnd a_3000_3269# a_2792_3269# gnd sky130_fd_pr__nfet_01v8 w=0.42 l=0.5
X10 a_2746_5488# a_2931_5986# a_2882_6176# gnd sky130_fd_pr__nfet_01v8 w=0.42 l=0.5
X11 a_2889_484# a_3142_471# a_2744_1253# gnd sky130_fd_pr__nfet_01v8 w=0.42 l=0.5
X12 gnd d1 a_3142_471# gnd sky130_fd_pr__nfet_01v8 w=0.42 l=0.5
X13 a_1511_7616# d2 gnd gnd sky130_fd_pr__nfet_01v8 w=0.42 l=0.5
X14 a_3826_2446# a_3822_2623# gnd sky130_fd_pr__res_generic_nd w=0.17 l=0.81
X15 vdd d0 a_4079_1330# vdd sky130_fd_pr__pfet_01v8 w=1 l=0.5
X16 a_3827_3000# a_4080_2987# a_2888_2690# gnd sky130_fd_pr__nfet_01v8 w=0.42 l=0.5
X17 a_2004_n382# a_2823_4353# a_2778_4366# vdd sky130_fd_pr__pfet_01v8 w=1 l=0.5
X18 a_1513_3204# d2 gnd gnd sky130_fd_pr__nfet_01v8 w=0.42 l=0.5
X19 a_2887_4896# a_3871_5193# a_3822_5383# gnd sky130_fd_pr__nfet_01v8 w=0.42 l=0.5
X20 a_2885_661# a_3142_471# a_2744_1253# vdd sky130_fd_pr__pfet_01v8 w=1 l=0.5
X21 vdd d1 a_3142_471# vdd sky130_fd_pr__pfet_01v8 w=1 l=0.5
X22 a_116_8562# a_116_8333# gnd sky130_fd_pr__res_generic_nd w=0.17 l=0.81
X23 a_647_5143# a_434_5143# gnd gnd sky130_fd_pr__nfet_01v8 w=0.42 l=0.5
X24 gnd a_3138_8192# a_2930_8192# gnd sky130_fd_pr__nfet_01v8 w=0.42 l=0.5
X25 a_3826_2446# a_4079_2433# a_2884_2867# gnd sky130_fd_pr__nfet_01v8 w=0.42 l=0.5
X26 a_3820_7035# a_4077_6845# a_2882_7279# vdd sky130_fd_pr__pfet_01v8 w=1 l=0.5
X27 a_119_3234# a_119_3047# gnd sky130_fd_pr__res_generic_nd w=0.17 l=0.81
X28 a_119_3047# a_648_2937# a_856_2937# gnd sky130_fd_pr__nfet_01v8 w=0.42 l=0.5
X29 a_117_6127# a_646_6246# a_854_6246# vdd sky130_fd_pr__pfet_01v8 w=1 l=0.5
X30 a_3822_2623# a_4079_2433# a_2884_2867# vdd sky130_fd_pr__pfet_01v8 w=1 l=0.5
X31 a_1586_2693# a_1373_2693# vdd vdd sky130_fd_pr__pfet_01v8 w=1 l=0.5
X32 a_1694_4326# a_1481_4326# vdd vdd sky130_fd_pr__pfet_01v8 w=1 l=0.5
X33 a_434_5143# d0 gnd gnd sky130_fd_pr__nfet_01v8 w=0.42 l=0.5
X34 a_2886_7102# a_3870_7399# a_3821_7589# gnd sky130_fd_pr__nfet_01v8 w=0.42 l=0.5
X35 a_118_3691# a_119_3234# gnd sky130_fd_pr__res_generic_nd w=0.17 l=0.81
X36 a_117_5897# a_645_5692# a_853_5692# gnd sky130_fd_pr__nfet_01v8 w=0.42 l=0.5
X37 a_2776_6578# a_2790_7681# a_2741_7871# gnd sky130_fd_pr__nfet_01v8 w=0.42 l=0.5
X38 a_2888_2690# a_3872_2987# a_3823_3177# gnd sky130_fd_pr__nfet_01v8 w=0.42 l=0.5
X39 a_646_7349# a_433_7349# gnd gnd sky130_fd_pr__nfet_01v8 w=0.42 l=0.5
X40 a_3826_1343# a_3822_1520# gnd sky130_fd_pr__res_generic_nd w=0.17 l=0.81
X41 a_2884_2867# a_3141_2677# a_2743_3459# vdd sky130_fd_pr__pfet_01v8 w=1 l=0.5
X42 a_119_1485# a_647_1280# a_855_1280# gnd sky130_fd_pr__nfet_01v8 w=0.42 l=0.5
X43 a_853_5692# a_1584_6002# a_1792_6002# vdd sky130_fd_pr__pfet_01v8 w=1 l=0.5
X44 gnd a_3031_4353# a_2823_4353# gnd sky130_fd_pr__nfet_01v8 w=0.42 l=0.5
X45 a_3825_4652# a_4078_4639# a_2883_5073# gnd sky130_fd_pr__nfet_01v8 w=0.42 l=0.5
X46 a_2776_6578# a_2790_7681# a_2745_7694# vdd sky130_fd_pr__pfet_01v8 w=1 l=0.5
X47 a_2741_7871# a_2931_7089# a_2886_7102# vdd sky130_fd_pr__pfet_01v8 w=1 l=0.5
X48 a_855_1280# a_434_1280# a_119_1485# vdd sky130_fd_pr__pfet_01v8 w=1 l=0.5
X49 gnd a_3139_5986# a_2931_5986# gnd sky130_fd_pr__nfet_01v8 w=0.42 l=0.5
X50 a_1373_2693# d1 vdd vdd sky130_fd_pr__pfet_01v8 w=1 l=0.5
X51 a_2778_2166# a_2792_3269# a_2747_3282# vdd sky130_fd_pr__pfet_01v8 w=1 l=0.5
X52 a_1481_4326# d4 vdd vdd sky130_fd_pr__pfet_01v8 w=1 l=0.5
X53 vdd a_3031_4353# a_2823_4353# vdd sky130_fd_pr__pfet_01v8 w=1 l=0.5
X54 a_2882_7279# a_3869_6845# a_3824_6858# vdd sky130_fd_pr__pfet_01v8 w=1 l=0.5
X55 gnd a_4079_5193# a_3871_5193# gnd sky130_fd_pr__nfet_01v8 w=0.42 l=0.5
X56 a_118_3921# a_647_4040# a_855_4040# vdd sky130_fd_pr__pfet_01v8 w=1 l=0.5
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
X187 a_2884_1764# a_3141_1574# a_2748_1076# vdd sky130_fd_pr__pfet_01v8 w=1 l=0.5
X188 a_432_6795# d0 gnd gnd sky130_fd_pr__nfet_01v8 w=0.42 l=0.5
X189 a_2747_3282# a_2932_3780# a_2887_3793# vdd sky130_fd_pr__pfet_01v8 w=1 l=0.5
X190 vdd d1 a_3138_8192# vdd sky130_fd_pr__pfet_01v8 w=1 l=0.5
X191 gnd a_4077_6845# a_3869_6845# gnd sky130_fd_pr__nfet_01v8 w=0.42 l=0.5
X192 a_117_7459# a_117_7230# gnd sky130_fd_pr__res_generic_nd w=0.17 l=0.81
X193 gnd d0 a_4079_5193# gnd sky130_fd_pr__nfet_01v8 w=0.42 l=0.5
X194 a_1373_1590# d1 vdd vdd sky130_fd_pr__pfet_01v8 w=1 l=0.5
X195 a_434_2383# d0 gnd gnd sky130_fd_pr__nfet_01v8 w=0.42 l=0.5
X196 gnd a_4081_781# a_3873_781# gnd sky130_fd_pr__nfet_01v8 w=0.42 l=0.5
X197 a_1791_8208# a_1370_8208# a_852_7898# gnd sky130_fd_pr__nfet_01v8 w=0.42 l=0.5
X198 a_1794_1590# a_1373_1590# a_855_1280# gnd sky130_fd_pr__nfet_01v8 w=0.42 l=0.5
X199 a_3823_7961# a_3819_8138# gnd sky130_fd_pr__res_generic_nd w=0.17 l=0.81
X200 vdd d0 a_4078_7399# vdd sky130_fd_pr__pfet_01v8 w=1 l=0.5
X201 a_854_3486# a_433_3486# a_118_3691# vdd sky130_fd_pr__pfet_01v8 w=1 l=0.5
X202 a_2887_4896# a_3871_5193# a_3826_5206# vdd sky130_fd_pr__pfet_01v8 w=1 l=0.5
X203 a_1792_7105# a_1371_7105# a_854_7349# vdd sky130_fd_pr__pfet_01v8 w=1 l=0.5
X204 a_3824_971# a_3827_240# gnd sky130_fd_pr__res_generic_nd w=0.17 l=0.81
X205 a_646_4589# a_433_4589# gnd gnd sky130_fd_pr__nfet_01v8 w=0.42 l=0.5
X206 vdd a_4081_781# a_3873_781# vdd sky130_fd_pr__pfet_01v8 w=1 l=0.5
X207 vout a_1682_n382# a_2004_n382# gnd sky130_fd_pr__nfet_01v8 w=0.42 l=0.5
X208 a_2886_7102# a_3139_7089# a_2741_7871# gnd sky130_fd_pr__nfet_01v8 w=0.42 l=0.5
X209 vdd a_3138_8192# a_2930_8192# vdd sky130_fd_pr__pfet_01v8 w=1 l=0.5
X210 a_2748_1076# a_2933_1574# a_2884_1764# gnd sky130_fd_pr__nfet_01v8 w=0.42 l=0.5
X211 a_3820_5932# a_3826_5206# gnd sky130_fd_pr__res_generic_nd w=0.17 l=0.81
X212 a_2746_5488# a_2931_5986# a_2886_5999# vdd sky130_fd_pr__pfet_01v8 w=1 l=0.5
X213 gnd d1 a_3140_4883# gnd sky130_fd_pr__nfet_01v8 w=0.42 l=0.5
X214 vdd a_4078_7399# a_3870_7399# vdd sky130_fd_pr__pfet_01v8 w=1 l=0.5
X215 a_120_1028# a_647_1280# a_855_1280# vdd sky130_fd_pr__pfet_01v8 w=1 l=0.5
X216 a_119_2588# a_119_2131# gnd sky130_fd_pr__res_generic_nd w=0.17 l=0.81
X217 a_2748_1076# a_2933_1574# a_2888_1587# vdd sky130_fd_pr__pfet_01v8 w=1 l=0.5
X218 a_645_8452# a_432_8452# vdd vdd sky130_fd_pr__pfet_01v8 w=1 l=0.5
X219 a_433_4589# d0 gnd gnd sky130_fd_pr__nfet_01v8 w=0.42 l=0.5
X220 vdd a_4080_2987# a_3872_2987# vdd sky130_fd_pr__pfet_01v8 w=1 l=0.5
X221 gnd d0 a_4080_2987# gnd sky130_fd_pr__nfet_01v8 w=0.42 l=0.5
X222 a_1793_3796# a_1372_3796# a_854_3486# gnd sky130_fd_pr__nfet_01v8 w=0.42 l=0.5
X223 vdd a_4080_227# a_3872_227# vdd sky130_fd_pr__pfet_01v8 w=1 l=0.5
X224 gnd a_3140_3780# a_2932_3780# gnd sky130_fd_pr__nfet_01v8 w=0.42 l=0.5
X225 a_117_6356# a_117_6127# gnd sky130_fd_pr__res_generic_nd w=0.17 l=0.81
X226 a_1793_4899# a_1372_4899# a_855_5143# vdd sky130_fd_pr__pfet_01v8 w=1 l=0.5
X227 a_119_1715# a_648_1834# a_856_1834# vdd sky130_fd_pr__pfet_01v8 w=1 l=0.5
X228 vdd d2 a_3000_3269# vdd sky130_fd_pr__pfet_01v8 w=1 l=0.5
X229 a_1895_n382# a_1682_n382# gnd gnd sky130_fd_pr__nfet_01v8 w=0.42 l=0.5
X230 vdd a_3140_3780# a_2932_3780# vdd sky130_fd_pr__pfet_01v8 w=1 l=0.5
X231 a_432_8452# d0 vdd vdd sky130_fd_pr__pfet_01v8 w=1 l=0.5
X232 gnd d1 a_3139_7089# gnd sky130_fd_pr__nfet_01v8 w=0.42 l=0.5
X233 a_3828_794# a_4081_781# a_2889_484# gnd sky130_fd_pr__nfet_01v8 w=0.42 l=0.5
X234 vdd a_4079_5193# a_3871_5193# vdd sky130_fd_pr__pfet_01v8 w=1 l=0.5
X235 a_117_6543# a_645_6795# a_853_6795# vdd sky130_fd_pr__pfet_01v8 w=1 l=0.5
X236 a_648_2937# a_435_2937# gnd gnd sky130_fd_pr__nfet_01v8 w=0.42 l=0.5
X237 a_855_5143# a_434_5143# a_118_5024# gnd sky130_fd_pr__nfet_01v8 w=0.42 l=0.5
X238 a_646_6246# a_433_6246# vdd vdd sky130_fd_pr__pfet_01v8 w=1 l=0.5
X239 gnd d2 a_2999_5475# gnd sky130_fd_pr__nfet_01v8 w=0.42 l=0.5
X240 a_857_731# a_1587_487# a_1795_487# gnd sky130_fd_pr__nfet_01v8 w=0.42 l=0.5
X241 a_1682_n382# d5 gnd gnd sky130_fd_pr__nfet_01v8 w=0.42 l=0.5
X242 a_119_2131# a_647_2383# a_855_2383# vdd sky130_fd_pr__pfet_01v8 w=1 l=0.5
X243 a_3824_971# a_4081_781# a_2889_484# vdd sky130_fd_pr__pfet_01v8 w=1 l=0.5
X244 a_119_1485# a_120_1028# gnd sky130_fd_pr__res_generic_nd w=0.17 l=0.81
X245 gnd d2 a_3001_1063# gnd sky130_fd_pr__nfet_01v8 w=0.42 l=0.5
X246 gnd a_3141_1574# a_2933_1574# gnd sky130_fd_pr__nfet_01v8 w=0.42 l=0.5
X247 vdd a_3139_5986# a_2931_5986# vdd sky130_fd_pr__pfet_01v8 w=1 l=0.5
X248 a_1795_487# a_1374_487# a_857_731# vdd sky130_fd_pr__pfet_01v8 w=1 l=0.5
X249 a_3822_4280# a_3825_3549# gnd sky130_fd_pr__res_generic_nd w=0.17 l=0.81
X250 a_1808_4445# a_1694_4326# a_1902_4326# gnd sky130_fd_pr__nfet_01v8 w=0.42 l=0.5
X251 vdd d2 a_2999_5475# vdd sky130_fd_pr__pfet_01v8 w=1 l=0.5
X252 a_1374_487# d1 vdd vdd sky130_fd_pr__pfet_01v8 w=1 l=0.5
X253 a_645_5692# a_432_5692# gnd gnd sky130_fd_pr__nfet_01v8 w=0.42 l=0.5
X254 a_3827_3000# a_3823_3177# gnd sky130_fd_pr__res_generic_nd w=0.17 l=0.81
X255 a_2885_8205# a_3138_8192# a_2745_7694# gnd sky130_fd_pr__nfet_01v8 w=0.42 l=0.5
X256 a_1803_6526# a_1694_6526# a_1808_4445# vdd sky130_fd_pr__pfet_01v8 w=1 l=0.5
X257 vdd d2 a_3001_1063# vdd sky130_fd_pr__pfet_01v8 w=1 l=0.5
X258 vdd a_3141_1574# a_2933_1574# vdd sky130_fd_pr__pfet_01v8 w=1 l=0.5
X259 a_647_1280# a_434_1280# gnd gnd sky130_fd_pr__nfet_01v8 w=0.42 l=0.5
X260 a_116_8103# a_117_7646# gnd sky130_fd_pr__res_generic_nd w=0.17 l=0.81
X261 a_435_2937# d0 gnd gnd sky130_fd_pr__nfet_01v8 w=0.42 l=0.5
X262 a_433_6246# d0 vdd vdd sky130_fd_pr__pfet_01v8 w=1 l=0.5
X263 a_120_382# a_122_283# gnd sky130_fd_pr__res_generic_nd w=0.17 l=0.81
X264 a_1805_2114# a_1696_2114# a_1803_4326# vdd sky130_fd_pr__pfet_01v8 w=1 l=0.5
X265 gnd a_4080_227# a_3872_227# gnd sky130_fd_pr__nfet_01v8 w=0.42 l=0.5
X266 a_854_7349# a_433_7349# a_117_7230# gnd sky130_fd_pr__nfet_01v8 w=0.42 l=0.5
X267 a_853_8452# a_1583_8208# a_1791_8208# gnd sky130_fd_pr__nfet_01v8 w=0.42 l=0.5
X268 a_854_3486# a_1585_3796# a_1793_3796# vdd sky130_fd_pr__pfet_01v8 w=1 l=0.5
X269 a_436_731# d0 gnd gnd sky130_fd_pr__nfet_01v8 w=0.42 l=0.5
X270 a_3823_417# a_4080_227# a_2885_661# vdd sky130_fd_pr__pfet_01v8 w=1 l=0.5
X271 a_647_4040# a_434_4040# vdd vdd sky130_fd_pr__pfet_01v8 w=1 l=0.5
X272 a_118_4337# a_646_4589# a_854_4589# vdd sky130_fd_pr__pfet_01v8 w=1 l=0.5
X273 a_432_5692# d0 gnd gnd sky130_fd_pr__nfet_01v8 w=0.42 l=0.5
X274 gnd d2 a_3000_3269# gnd sky130_fd_pr__nfet_01v8 w=0.42 l=0.5
X275 gnd d0 a_4079_4090# gnd sky130_fd_pr__nfet_01v8 w=0.42 l=0.5
X276 a_434_1280# d0 gnd gnd sky130_fd_pr__nfet_01v8 w=0.42 l=0.5
X277 a_644_7898# a_431_7898# gnd gnd sky130_fd_pr__nfet_01v8 w=0.42 l=0.5
X278 gnd d0 a_4076_7948# gnd sky130_fd_pr__nfet_01v8 w=0.42 l=0.5
X279 a_3819_8138# a_3825_7412# gnd sky130_fd_pr__res_generic_nd w=0.17 l=0.81
X280 a_1792_6002# a_1371_6002# a_854_6246# vdd sky130_fd_pr__pfet_01v8 w=1 l=0.5
X281 a_1587_487# a_1374_487# gnd gnd sky130_fd_pr__nfet_01v8 w=0.42 l=0.5
X282 a_646_3486# a_433_3486# gnd gnd sky130_fd_pr__nfet_01v8 w=0.42 l=0.5
X283 a_2887_3793# a_3871_4090# a_3826_4103# vdd sky130_fd_pr__pfet_01v8 w=1 l=0.5
X284 a_435_177# d0 vdd vdd sky130_fd_pr__pfet_01v8 w=1 l=0.5
X285 a_1902_4326# a_1481_4326# a_1803_4326# gnd sky130_fd_pr__nfet_01v8 w=0.42 l=0.5
X286 a_2886_5999# a_3139_5986# a_2746_5488# gnd sky130_fd_pr__nfet_01v8 w=0.42 l=0.5
X287 a_1808_4445# a_1481_6526# a_1808_6645# vdd sky130_fd_pr__pfet_01v8 w=1 l=0.5
X288 gnd a_3142_471# a_2934_471# gnd sky130_fd_pr__nfet_01v8 w=0.42 l=0.5
X289 a_434_4040# d0 vdd vdd sky130_fd_pr__pfet_01v8 w=1 l=0.5
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
X385 a_1584_6002# a_1371_6002# gnd gnd sky130_fd_pr__nfet_01v8 w=0.42 l=0.5
X386 a_2885_8205# a_3869_8502# a_3820_8692# gnd sky130_fd_pr__nfet_01v8 w=0.42 l=0.5
X387 gnd a_4078_4639# a_3870_4639# gnd sky130_fd_pr__nfet_01v8 w=0.42 l=0.5
X388 a_1694_6526# a_1481_6526# gnd gnd sky130_fd_pr__nfet_01v8 w=0.42 l=0.5
X389 vdd d1 a_3140_4883# vdd sky130_fd_pr__pfet_01v8 w=1 l=0.5
X390 a_3821_3726# a_3827_3000# gnd sky130_fd_pr__res_generic_nd w=0.17 l=0.81
X391 a_1696_2114# a_1483_2114# gnd gnd sky130_fd_pr__nfet_01v8 w=0.42 l=0.5
X392 a_118_5440# a_118_5253# gnd sky130_fd_pr__res_generic_nd w=0.17 l=0.81
X393 a_3828_794# a_3824_971# gnd sky130_fd_pr__res_generic_nd w=0.17 l=0.81
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
