vsdip/avsddac_3v3_sky130_v2/Post Layout Simulations/7bit_DAC_test.spice

* SPICE3 file created from 7bit_DAC.ext - technology: sky130A

.lib "sky130_fd_pr/models/sky130.lib.spice" tt

X0 a_2745_8212# a_2998_8199# a_2776_7096# gnd sky130_fd_pr__nfet_01v8 w=0.42 l=0.5
X1 a_3822_2038# a_3828_1312# gnd sky130_fd_pr__res_generic_nd w=0.17 l=0.81
X2 a_5490_2942# d0 gnd gnd sky130_fd_pr__nfet_01v8 w=0.42 l=0.5
X3 a_5705_1290# a_5492_1290# vdd vdd sky130_fd_pr__pfet_01v8 w=1 l=0.5
X4 a_7799_4018# a_7989_3236# a_7944_3249# vdd sky130_fd_pr__pfet_01v8 w=1 l=0.5
X5 a_120_1130# a_649_1249# a_857_1249# vdd sky130_fd_pr__pfet_01v8 w=1 l=0.5
X6 a_119_3752# a_119_3565# gnd sky130_fd_pr__res_generic_nd w=0.17 l=0.81
X7 a_5704_736# a_5491_736# gnd gnd sky130_fd_pr__nfet_01v8 w=0.42 l=0.5
X8 a_7830_2902# a_7849_1622# a_7800_1812# gnd sky130_fd_pr__nfet_01v8 w=0.42 l=0.5
X9 a_1586_2108# a_1373_2108# vdd vdd sky130_fd_pr__pfet_01v8 w=1 l=0.5
X10 a_1808_4963# a_1481_7044# a_1803_7044# gnd sky130_fd_pr__nfet_01v8 w=0.42 l=0.5
X11 a_6849_5458# a_6428_5458# a_5910_5148# gnd sky130_fd_pr__nfet_01v8 w=0.42 l=0.5
X12 a_8878_4839# a_9135_4649# a_7943_4352# vdd sky130_fd_pr__pfet_01v8 w=1 l=0.5
X13 gnd a_3001_1581# a_2793_1581# gnd sky130_fd_pr__nfet_01v8 w=0.42 l=0.5
X14 a_2888_2105# a_3141_2092# a_2748_1594# gnd sky130_fd_pr__nfet_01v8 w=0.42 l=0.5
X15 a_7937_8941# a_8924_8507# a_8875_8697# gnd sky130_fd_pr__nfet_01v8 w=0.42 l=0.5
X16 a_5909_6251# a_6640_6561# a_6848_6561# vdd sky130_fd_pr__pfet_01v8 w=1 l=0.5
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
X383 a_3824_1489# a_4081_1299# a_2889_1002# vdd sky130_fd_pr__pfet_01v8 w=1 l=0.5
X384 a_2883_5591# a_3870_5157# a_3821_5347# gnd sky130_fd_pr__nfet_01v8 w=0.42 l=0.5
X385 vdd a_4078_5157# a_3870_5157# vdd sky130_fd_pr__pfet_01v8 w=1 l=0.5
X386 a_6570_1557# d2 vdd vdd sky130_fd_pr__pfet_01v8 w=1 l=0.5
X387 a_2885_1179# a_3872_745# a_3823_935# gnd sky130_fd_pr__nfet_01v8 w=0.42 l=0.5
X388 gnd a_4080_2402# a_3872_2402# gnd sky130_fd_pr__nfet_01v8 w=0.42 l=0.5
X389 a_3821_7004# a_3824_6273# gnd sky130_fd_pr__res_generic_nd w=0.17 l=0.81
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
