vsdip/avsddac_3v3_sky130_v2/Post Layout Simulations/8bit_DAC_test.spice

* SPICE3 file created from 8bit_DAC.ext - technology: sky130A

.lib "sky130_fd_pr/models/sky130.lib.spice" tt

X0 a_11826_1027# a_11405_1027# a_10888_1271# vdd sky130_fd_pr__pfet_01v8 w=1 l=0.5
X1 a_10677_5129# a_10464_5129# gnd gnd sky130_fd_pr__nfet_01v8 w=0.42 l=0.5
X2 a_13858_780# a_13854_957# gnd sky130_fd_pr__res_generic_nd w=0.17 l=0.81
X3 gnd d0 a_19166_5774# gnd sky130_fd_pr__nfet_01v8 w=0.42 l=0.5
X4 a_7800_1829# a_8057_1639# a_7830_2919# vdd sky130_fd_pr__pfet_01v8 w=1 l=0.5
X5 a_15207_1193# a_15207_963# gnd sky130_fd_pr__res_generic_nd w=0.17 l=0.81
X6 gnd a_2999_6010# a_2791_6010# gnd sky130_fd_pr__nfet_01v8 w=0.42 l=0.5
X7 vdd a_19167_3568# a_18959_3568# vdd sky130_fd_pr__pfet_01v8 w=1 l=0.5
X8 a_1512_5945# d2 vdd vdd sky130_fd_pr__pfet_01v8 w=1 l=0.5
X9 vdd d2 a_13030_6015# vdd sky130_fd_pr__pfet_01v8 w=1 l=0.5
X10 vdd a_13170_6526# a_12962_6526# vdd sky130_fd_pr__pfet_01v8 w=1 l=0.5
X11 a_7834_4942# a_7877_7141# a_7828_7331# gnd sky130_fd_pr__nfet_01v8 w=0.42 l=0.5
X12 a_2748_1611# a_3001_1598# a_2774_2878# gnd sky130_fd_pr__nfet_01v8 w=0.42 l=0.5
X13 a_11512_7066# d3 gnd gnd sky130_fd_pr__nfet_01v8 w=0.42 l=0.5
X14 a_10466_3477# d0 vdd vdd sky130_fd_pr__pfet_01v8 w=1 l=0.5
X15 a_5173_6932# a_5702_6822# a_5910_6822# gnd sky130_fd_pr__nfet_01v8 w=0.42 l=0.5
X16 a_15940_7376# a_15519_7376# a_15204_7581# vdd sky130_fd_pr__pfet_01v8 w=1 l=0.5
X17 a_15206_2066# a_15734_1861# a_15942_1861# gnd sky130_fd_pr__nfet_01v8 w=0.42 l=0.5
X18 a_15941_4067# a_15520_4067# a_15206_3815# gnd sky130_fd_pr__nfet_01v8 w=0.42 l=0.5
X19 gnd a_3029_7100# a_2821_7100# gnd sky130_fd_pr__nfet_01v8 w=0.42 l=0.5
X20 a_10885_6786# a_10464_6786# a_10148_6896# vdd sky130_fd_pr__pfet_01v8 w=1 l=0.5
X21 gnd d0 a_19168_1362# gnd sky130_fd_pr__nfet_01v8 w=0.42 l=0.5
X22 a_5490_4616# d0 gnd gnd sky130_fd_pr__nfet_01v8 w=0.42 l=0.5
X23 a_9779_17# a_9566_17# vdd vdd sky130_fd_pr__pfet_01v8 w=1 l=0.5
X24 vdd d1 a_18228_2155# vdd sky130_fd_pr__pfet_01v8 w=1 l=0.5
X25 a_7943_5472# a_8196_5459# a_7798_6241# gnd sky130_fd_pr__nfet_01v8 w=0.42 l=0.5
X26 a_855_4575# a_1585_4331# a_1793_4331# gnd sky130_fd_pr__nfet_01v8 w=0.42 l=0.5
X27 gnd d2 a_2998_8216# gnd sky130_fd_pr__nfet_01v8 w=0.42 l=0.5
X28 a_1370_8743# d1 vdd vdd sky130_fd_pr__pfet_01v8 w=1 l=0.5
X29 a_8879_2650# a_8882_1919# gnd sky130_fd_pr__res_generic_nd w=0.17 l=0.81
X30 a_3824_6290# a_4077_6277# a_2882_6711# gnd sky130_fd_pr__nfet_01v8 w=0.42 l=0.5
X31 a_7797_8447# a_7987_7665# a_7938_7855# gnd sky130_fd_pr__nfet_01v8 w=0.42 l=0.5
X32 a_13851_7575# a_13856_6849# gnd sky130_fd_pr__res_generic_nd w=0.17 l=0.81
X33 a_118_5329# a_646_5124# a_854_5124# gnd sky130_fd_pr__nfet_01v8 w=0.42 l=0.5
X34 vdd d0 a_19166_5774# vdd sky130_fd_pr__pfet_01v8 w=1 l=0.5
X35 a_15942_2964# a_15521_2964# a_15206_3169# vdd sky130_fd_pr__pfet_01v8 w=1 l=0.5
X36 vdd a_2999_6010# a_2791_6010# vdd sky130_fd_pr__pfet_01v8 w=1 l=0.5
X37 a_118_4226# a_119_3769# gnd sky130_fd_pr__res_generic_nd w=0.17 l=0.81
X38 a_5491_3513# d0 vdd vdd sky130_fd_pr__pfet_01v8 w=1 l=0.5
X39 gnd a_18226_6567# a_18018_6567# gnd sky130_fd_pr__nfet_01v8 w=0.42 l=0.5
X40 a_7945_1060# a_8198_1047# a_7800_1829# gnd sky130_fd_pr__nfet_01v8 w=0.42 l=0.5
X41 a_2881_8917# a_3868_8483# a_3819_8673# gnd sky130_fd_pr__nfet_01v8 w=0.42 l=0.5
X42 a_7834_4942# a_7877_7141# a_7832_7154# vdd sky130_fd_pr__pfet_01v8 w=1 l=0.5
X43 a_16880_5480# a_16459_5480# a_15942_5724# vdd sky130_fd_pr__pfet_01v8 w=1 l=0.5
X44 a_6859_7102# a_6750_7102# a_6864_5021# vdd sky130_fd_pr__pfet_01v8 w=1 l=0.5
X45 a_1372_4331# d1 vdd vdd sky130_fd_pr__pfet_01v8 w=1 l=0.5
X46 a_10149_5334# a_10149_4877# gnd sky130_fd_pr__res_generic_nd w=0.17 l=0.81
X47 a_3826_1878# a_4079_1865# a_2884_2299# gnd sky130_fd_pr__nfet_01v8 w=0.42 l=0.5
X48 vdd d0 a_19168_1362# vdd sky130_fd_pr__pfet_01v8 w=1 l=0.5
X49 a_7799_4035# a_7989_3253# a_7940_3443# gnd sky130_fd_pr__nfet_01v8 w=0.42 l=0.5
X50 a_10150_2484# a_10150_2255# gnd sky130_fd_pr__res_generic_nd w=0.17 l=0.81
X51 a_13856_6849# a_14109_6836# a_12917_6539# gnd sky130_fd_pr__nfet_01v8 w=0.42 l=0.5
X52 a_118_5788# a_118_5559# gnd sky130_fd_pr__res_generic_nd w=0.17 l=0.81
X53 gnd a_18228_2155# a_18020_2155# gnd sky130_fd_pr__nfet_01v8 w=0.42 l=0.5
X54 vdd d2 a_2998_8216# vdd sky130_fd_pr__pfet_01v8 w=1 l=0.5
X55 a_7943_5472# a_8927_5769# a_8878_5959# gnd sky130_fd_pr__nfet_01v8 w=0.42 l=0.5
X56 vdd a_18118_4934# a_17910_4934# vdd sky130_fd_pr__pfet_01v8 w=1 l=0.5
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
X376 vdd a_14110_1870# a_13902_1870# vdd sky130_fd_pr__pfet_01v8 w=1 l=0.5
X377 a_4845_133# a_4632_133# gnd gnd sky130_fd_pr__nfet_01v8 w=0.42 l=0.5
X378 a_18910_2655# a_18913_1924# gnd sky130_fd_pr__res_generic_nd w=0.17 l=0.81
X379 a_1513_3739# d2 gnd gnd sky130_fd_pr__nfet_01v8 w=0.42 l=0.5
X380 a_11404_3233# d1 gnd gnd sky130_fd_pr__nfet_01v8 w=0.42 l=0.5
X381 a_10149_4877# a_10149_4690# gnd sky130_fd_pr__res_generic_nd w=0.17 l=0.81
X382 a_7941_1237# a_8928_803# a_8883_816# vdd sky130_fd_pr__pfet_01v8 w=1 l=0.5
X383 a_435_3472# d0 gnd gnd sky130_fd_pr__nfet_01v8 w=0.42 l=0.5
X384 a_6849_4372# a_6428_4372# a_5910_4062# gnd sky130_fd_pr__nfet_01v8 w=0.42 l=0.5
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
