vsdip/avsddac_3v3_sky130_v2/Post Layout Simulations/9bit_DAC_test.spice

* SPICE3 file created from 9bit_DAC.ext - technology: sky130A

.lib "sky130_fd_pr/models/sky130.lib.spice" tt

X0 a_31071_8063# a_30650_8063# a_30334_8173# vdd sky130_fd_pr__pfet_01v8 w=1 l=0.5
X1 a_39098_4304# a_39094_4481# gnd sky130_fd_pr__res_generic_nd w=0.17 l=0.81
X2 a_15943_951# a_16674_1261# a_16882_1261# vdd sky130_fd_pr__pfet_01v8 w=1 l=0.5
X3 a_12776_8427# a_13029_8414# a_12807_7311# gnd sky130_fd_pr__nfet_01v8 w=0.42 l=0.5
X4 a_853_7523# a_432_7523# a_117_7728# vdd sky130_fd_pr__pfet_01v8 w=1 l=0.5
X5 vdd d0 a_4080_2612# vdd sky130_fd_pr__pfet_01v8 w=1 l=0.5
X6 a_34038_5543# a_34043_4817# gnd sky130_fd_pr__res_generic_nd w=0.17 l=0.81
X7 a_10150_3967# a_10677_4219# a_10885_4219# vdd sky130_fd_pr__pfet_01v8 w=1 l=0.5
X8 a_854_4214# a_433_4214# a_119_3962# gnd sky130_fd_pr__nfet_01v8 w=0.42 l=0.5
X9 a_11825_2323# a_11758_1731# a_11836_2847# gnd sky130_fd_pr__nfet_01v8 w=0.42 l=0.5
X10 a_26098_3687# a_25677_3687# a_25361_3797# vdd sky130_fd_pr__pfet_01v8 w=1 l=0.5
X11 a_6864_7414# a_6567_8385# a_6848_7874# gnd sky130_fd_pr__nfet_01v8 w=0.42 l=0.5
X12 a_7938_8048# a_8195_7858# a_7797_8640# vdd sky130_fd_pr__pfet_01v8 w=1 l=0.5
X13 vdd d0 a_24267_1490# vdd sky130_fd_pr__pfet_01v8 w=1 l=0.5
X14 a_35392_2240# a_35393_1783# gnd sky130_fd_pr__res_generic_nd w=0.17 l=0.81
X15 vdd a_14111_2617# a_13903_2617# vdd sky130_fd_pr__pfet_01v8 w=1 l=0.5
X16 vdd a_33215_8395# a_33007_8395# vdd sky130_fd_pr__pfet_01v8 w=1 l=0.5
X17 gnd d1 a_28383_2324# gnd sky130_fd_pr__nfet_01v8 w=0.42 l=0.5
X18 a_12919_2320# a_13903_2617# a_13854_2807# gnd sky130_fd_pr__nfet_01v8 w=0.42 l=0.5
X19 a_8878_3392# a_8883_2666# gnd sky130_fd_pr__res_generic_nd w=0.17 l=0.81
X20 gnd a_9132_8717# a_8924_8717# gnd sky130_fd_pr__nfet_01v8 w=0.42 l=0.5
X21 a_19317_134# a_19208_134# vout vdd sky130_fd_pr__pfet_01v8 w=1 l=0.5
X22 a_6738_387# d5 vdd vdd sky130_fd_pr__pfet_01v8 w=1 l=0.5
X23 a_35708_3692# d0 gnd gnd sky130_fd_pr__nfet_01v8 w=0.42 l=0.5
X24 a_5173_6666# a_5701_6461# a_5909_6461# gnd sky130_fd_pr__nfet_01v8 w=0.42 l=0.5
X25 a_21041_4749# a_20620_4749# a_20304_4859# vdd sky130_fd_pr__pfet_01v8 w=1 l=0.5
X26 a_23074_2296# a_24058_2593# a_24013_2606# vdd sky130_fd_pr__pfet_01v8 w=1 l=0.5
X27 a_2778_2894# a_3031_2881# a_2774_5271# gnd sky130_fd_pr__nfet_01v8 w=0.42 l=0.5
X28 a_12778_4015# a_12963_4513# a_12918_4526# vdd sky130_fd_pr__pfet_01v8 w=1 l=0.5
X29 vdd a_33218_1777# a_33010_1777# vdd sky130_fd_pr__pfet_01v8 w=1 l=0.5
X30 a_10149_4654# a_10149_4424# gnd sky130_fd_pr__res_generic_nd w=0.17 l=0.81
X31 a_30074_191# a_29965_191# a_19317_134# vdd sky130_fd_pr__pfet_01v8 w=1 l=0.5
X32 a_20620_5852# d0 gnd gnd sky130_fd_pr__nfet_01v8 w=0.42 l=0.5
X33 a_27989_4032# a_28174_4530# a_28125_4720# gnd sky130_fd_pr__nfet_01v8 w=0.42 l=0.5
X34 a_117_7958# a_117_7728# gnd sky130_fd_pr__res_generic_nd w=0.17 l=0.81
X35 a_10884_6425# a_10463_6425# a_10148_6630# vdd sky130_fd_pr__pfet_01v8 w=1 l=0.5
X36 a_25675_5339# d0 vdd vdd sky130_fd_pr__pfet_01v8 w=1 l=0.5
X37 a_21981_1196# a_21560_1196# a_21043_1440# vdd sky130_fd_pr__pfet_01v8 w=1 l=0.5
X38 gnd d0 a_19167_1001# gnd sky130_fd_pr__nfet_01v8 w=0.42 l=0.5
X39 a_15942_5917# a_15521_5917# a_15205_5798# gnd sky130_fd_pr__nfet_01v8 w=0.42 l=0.5
X40 a_13859_1527# a_13855_1704# gnd sky130_fd_pr__res_generic_nd w=0.17 l=0.81
X41 a_5909_9221# a_6639_8977# a_6847_8977# gnd sky130_fd_pr__nfet_01v8 w=0.42 l=0.5
X42 vdd d1 a_28381_6736# vdd sky130_fd_pr__pfet_01v8 w=1 l=0.5
X43 a_8884_1563# a_9137_1550# a_7945_1253# gnd sky130_fd_pr__nfet_01v8 w=0.42 l=0.5
X44 a_5176_1151# a_5178_1052# gnd sky130_fd_pr__res_generic_nd w=0.17 l=0.81
X45 a_15940_9226# a_15519_9226# a_15203_9336# vdd sky130_fd_pr__pfet_01v8 w=1 l=0.5
X46 a_855_3111# a_434_3111# a_119_3316# vdd sky130_fd_pr__pfet_01v8 w=1 l=0.5
X47 a_35392_3573# a_35921_3692# a_36129_3692# vdd sky130_fd_pr__pfet_01v8 w=1 l=0.5
X48 gnd d0 a_34295_7010# gnd sky130_fd_pr__nfet_01v8 w=0.42 l=0.5
X49 a_13856_4282# a_13852_4459# gnd sky130_fd_pr__res_generic_nd w=0.17 l=0.81
X50 a_24007_8298# a_24010_7567# gnd sky130_fd_pr__res_generic_nd w=0.17 l=0.81
X51 a_39095_2275# a_39352_2085# a_38157_2519# vdd sky130_fd_pr__pfet_01v8 w=1 l=0.5
X52 vdd a_29322_3737# a_29114_3737# vdd sky130_fd_pr__pfet_01v8 w=1 l=0.5
X53 gnd d0 a_14110_5926# gnd sky130_fd_pr__nfet_01v8 w=0.42 l=0.5
X54 a_11823_6735# a_11402_6735# a_10884_6425# gnd sky130_fd_pr__nfet_01v8 w=0.42 l=0.5
X55 vdd a_23325_6695# a_23117_6695# vdd sky130_fd_pr__pfet_01v8 w=1 l=0.5
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
X227 a_6859_7295# a_6568_6179# a_6849_5668# gnd sky130_fd_pr__nfet_01v8 w=0.42 l=0.5
X228 a_7939_5842# a_8196_5652# a_7798_6434# vdd sky130_fd_pr__pfet_01v8 w=1 l=0.5
X229 a_35920_2035# a_35707_2035# vdd vdd sky130_fd_pr__pfet_01v8 w=1 l=0.5
X230 a_855_2008# a_434_2008# a_120_1756# gnd sky130_fd_pr__nfet_01v8 w=0.42 l=0.5
X231 a_20304_5962# a_20833_5852# a_21041_5852# gnd sky130_fd_pr__nfet_01v8 w=0.42 l=0.5
X232 a_38049_7333# a_38063_8436# a_38018_8449# vdd sky130_fd_pr__pfet_01v8 w=1 l=0.5
X233 a_25890_3687# a_25677_3687# gnd gnd sky130_fd_pr__nfet_01v8 w=0.42 l=0.5
X234 a_5173_7312# a_5701_7564# a_5909_7564# vdd sky130_fd_pr__pfet_01v8 w=1 l=0.5
X235 a_35709_1486# d0 gnd gnd sky130_fd_pr__nfet_01v8 w=0.42 l=0.5
X236 gnd a_33248_2867# a_33040_2867# gnd sky130_fd_pr__nfet_01v8 w=0.42 l=0.5
X237 vdd d2 a_2998_8409# vdd sky130_fd_pr__pfet_01v8 w=1 l=0.5
X238 a_5174_4460# a_5702_4255# a_5910_4255# gnd sky130_fd_pr__nfet_01v8 w=0.42 l=0.5
X239 a_34039_4994# a_34296_4804# a_33104_4507# vdd sky130_fd_pr__pfet_01v8 w=1 l=0.5
X240 a_20302_9042# a_20831_9161# a_21039_9161# vdd sky130_fd_pr__pfet_01v8 w=1 l=0.5
X241 a_37065_7860# a_36644_7860# a_36126_7550# gnd sky130_fd_pr__nfet_01v8 w=0.42 l=0.5
X242 vdd a_34295_7010# a_34087_7010# vdd sky130_fd_pr__pfet_01v8 w=1 l=0.5
X243 a_6861_2883# a_6570_1767# a_6850_2359# vdd sky130_fd_pr__pfet_01v8 w=1 l=0.5
X244 a_38158_8960# a_39142_9257# gnd vdd sky130_fd_pr__pfet_01v8 w=1 l=0.5
X245 a_30863_8063# a_30650_8063# vdd vdd sky130_fd_pr__pfet_01v8 w=1 l=0.5
X246 a_31070_6406# a_31801_6716# a_32009_6716# vdd sky130_fd_pr__pfet_01v8 w=1 l=0.5
X247 a_30335_5738# a_30335_5508# gnd sky130_fd_pr__res_generic_nd w=0.17 l=0.81
X248 a_16882_1261# a_16461_1261# a_15944_1505# vdd sky130_fd_pr__pfet_01v8 w=1 l=0.5
X249 a_28124_8029# a_29111_7595# a_29066_7608# vdd sky130_fd_pr__pfet_01v8 w=1 l=0.5
X250 a_3820_6660# a_4077_6470# a_2882_6904# vdd sky130_fd_pr__pfet_01v8 w=1 l=0.5
X251 a_10885_4219# a_10464_4219# a_10149_4424# vdd sky130_fd_pr__pfet_01v8 w=1 l=0.5
X252 a_20621_3646# d0 gnd gnd sky130_fd_pr__nfet_01v8 w=0.42 l=0.5
X253 a_19317_134# a_29752_191# a_30074_191# gnd sky130_fd_pr__nfet_01v8 w=0.42 l=0.5
X254 a_11836_2847# a_11545_1731# a_11826_1220# gnd sky130_fd_pr__nfet_01v8 w=0.42 l=0.5
X255 a_27990_1826# a_28175_2324# a_28126_2514# gnd sky130_fd_pr__nfet_01v8 w=0.42 l=0.5
X256 a_7797_8640# a_7987_7858# a_7942_7871# vdd sky130_fd_pr__pfet_01v8 w=1 l=0.5
X257 a_5704_2603# a_5491_2603# gnd gnd sky130_fd_pr__nfet_01v8 w=0.42 l=0.5
X258 a_16568_5100# d4 gnd gnd sky130_fd_pr__nfet_01v8 w=0.42 l=0.5
X259 gnd d0 a_29322_3737# gnd sky130_fd_pr__nfet_01v8 w=0.42 l=0.5
X260 a_5490_2049# d0 gnd gnd sky130_fd_pr__nfet_01v8 w=0.42 l=0.5
X261 a_16890_5100# a_16570_2888# a_16892_2888# gnd sky130_fd_pr__nfet_01v8 w=0.42 l=0.5
X262 a_10464_5322# d0 gnd gnd sky130_fd_pr__nfet_01v8 w=0.42 l=0.5
X263 a_26755_3954# d2 vdd vdd sky130_fd_pr__pfet_01v8 w=1 l=0.5
X264 a_31899_332# d5 gnd gnd sky130_fd_pr__nfet_01v8 w=0.42 l=0.5
X265 gnd d2 a_13029_8414# gnd sky130_fd_pr__nfet_01v8 w=0.42 l=0.5
X266 a_5909_6461# a_5488_6461# a_5174_6209# gnd sky130_fd_pr__nfet_01v8 w=0.42 l=0.5
X267 a_25360_6003# a_25360_5774# gnd sky130_fd_pr__res_generic_nd w=0.17 l=0.81
X268 a_32320_332# a_35062_312# a_30074_191# gnd sky130_fd_pr__nfet_01v8 w=0.42 l=0.5
X269 a_21669_2823# d3 vdd vdd sky130_fd_pr__pfet_01v8 w=1 l=0.5
X270 a_2774_5271# a_2823_2881# a_2774_3071# gnd sky130_fd_pr__nfet_01v8 w=0.42 l=0.5
X271 a_15941_7020# a_15520_7020# a_15204_7130# vdd sky130_fd_pr__pfet_01v8 w=1 l=0.5
X272 a_21994_7354# a_21880_7235# a_21994_5154# gnd sky130_fd_pr__nfet_01v8 w=0.42 l=0.5
X273 a_118_5752# a_647_5871# a_855_5871# vdd sky130_fd_pr__pfet_01v8 w=1 l=0.5
X274 a_15205_4695# a_15734_4814# a_15942_4814# vdd sky130_fd_pr__pfet_01v8 w=1 l=0.5
X275 vdd a_18226_6760# a_18018_6760# vdd sky130_fd_pr__pfet_01v8 w=1 l=0.5
X276 a_35393_1367# a_35922_1486# a_36130_1486# vdd sky130_fd_pr__pfet_01v8 w=1 l=0.5
X277 a_856_905# a_435_905# a_120_1110# vdd sky130_fd_pr__pfet_01v8 w=1 l=0.5
X278 vdd a_29323_1531# a_29115_1531# vdd sky130_fd_pr__pfet_01v8 w=1 l=0.5
X279 a_7941_1430# a_8198_1240# a_7800_2022# vdd sky130_fd_pr__pfet_01v8 w=1 l=0.5
X280 a_119_2672# a_648_2562# a_856_2562# gnd sky130_fd_pr__nfet_01v8 w=0.42 l=0.5
X281 a_25358_8853# a_25359_8396# gnd sky130_fd_pr__res_generic_nd w=0.17 l=0.81
X282 a_11823_7838# a_11402_7838# a_10885_8082# vdd sky130_fd_pr__pfet_01v8 w=1 l=0.5
X283 a_15520_8123# d0 gnd gnd sky130_fd_pr__nfet_01v8 w=0.42 l=0.5
X284 a_29065_8711# a_29318_8698# a_28123_9132# gnd sky130_fd_pr__nfet_01v8 w=0.42 l=0.5
X285 a_32958_8585# a_33148_7803# a_33103_7816# vdd sky130_fd_pr__pfet_01v8 w=1 l=0.5
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
X340 vdd d2 a_13029_8414# vdd sky130_fd_pr__pfet_01v8 w=1 l=0.5
X341 vdd a_19166_5967# a_18958_5967# vdd sky130_fd_pr__pfet_01v8 w=1 l=0.5
X342 a_37067_3448# a_36999_3959# a_37083_2988# vdd sky130_fd_pr__pfet_01v8 w=1 l=0.5
X343 vdd a_13169_8925# a_12961_8925# vdd sky130_fd_pr__pfet_01v8 w=1 l=0.5
X344 a_5912_946# a_6643_1256# a_6851_1256# vdd sky130_fd_pr__pfet_01v8 w=1 l=0.5
X345 vdd a_24266_3696# a_24058_3696# vdd sky130_fd_pr__pfet_01v8 w=1 l=0.5
X346 a_32022_2828# a_31913_2828# a_32020_5040# vdd sky130_fd_pr__pfet_01v8 w=1 l=0.5
X347 a_36127_8104# a_35706_8104# a_35390_8214# vdd sky130_fd_pr__pfet_01v8 w=1 l=0.5
X348 a_11933_5059# a_11512_5059# a_11839_5178# vdd sky130_fd_pr__pfet_01v8 w=1 l=0.5
X349 a_29063_8339# a_29320_8149# a_28128_7852# vdd sky130_fd_pr__pfet_01v8 w=1 l=0.5
X350 a_24007_7195# a_24010_6464# gnd sky130_fd_pr__res_generic_nd w=0.17 l=0.81
X351 a_10465_5876# d0 vdd vdd sky130_fd_pr__pfet_01v8 w=1 l=0.5
X352 a_10148_7963# a_10148_7733# gnd sky130_fd_pr__res_generic_nd w=0.17 l=0.81
X353 a_25887_6442# a_25674_6442# vdd vdd sky130_fd_pr__pfet_01v8 w=1 l=0.5
X354 gnd a_28382_5633# a_28174_5633# gnd sky130_fd_pr__nfet_01v8 w=0.42 l=0.5
X355 a_35392_2699# a_35392_2470# gnd sky130_fd_pr__res_generic_nd w=0.17 l=0.81
X356 a_10466_2567# d0 gnd gnd sky130_fd_pr__nfet_01v8 w=0.42 l=0.5
X357 a_25890_927# a_25677_927# gnd gnd sky130_fd_pr__nfet_01v8 w=0.42 l=0.5
X358 gnd d3 a_28271_7315# gnd sky130_fd_pr__nfet_01v8 w=0.42 l=0.5
X359 a_15940_6466# a_15519_6466# a_15205_6214# gnd sky130_fd_pr__nfet_01v8 w=0.42 l=0.5
X360 gnd d0 a_29319_6492# gnd sky130_fd_pr__nfet_01v8 w=0.42 l=0.5
X361 a_7945_1253# a_8929_1550# a_8884_1563# vdd sky130_fd_pr__pfet_01v8 w=1 l=0.5
X362 a_33103_6713# a_34087_7010# a_34042_7023# vdd sky130_fd_pr__pfet_01v8 w=1 l=0.5
X363 a_10678_3116# a_10465_3116# gnd gnd sky130_fd_pr__nfet_01v8 w=0.42 l=0.5
X364 a_6782_3973# a_6569_3973# vdd vdd sky130_fd_pr__pfet_01v8 w=1 l=0.5
X365 gnd a_39351_4291# a_39143_4291# gnd sky130_fd_pr__nfet_01v8 w=0.42 l=0.5
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
