vsdip/avsddac_3v3_sky130_v2/subcircuits/5bit_DACa/5bit_DACa.sch

## KiCad design subcircuits/5bit_DACa/5bit_DACa.sch (2021-03-26)

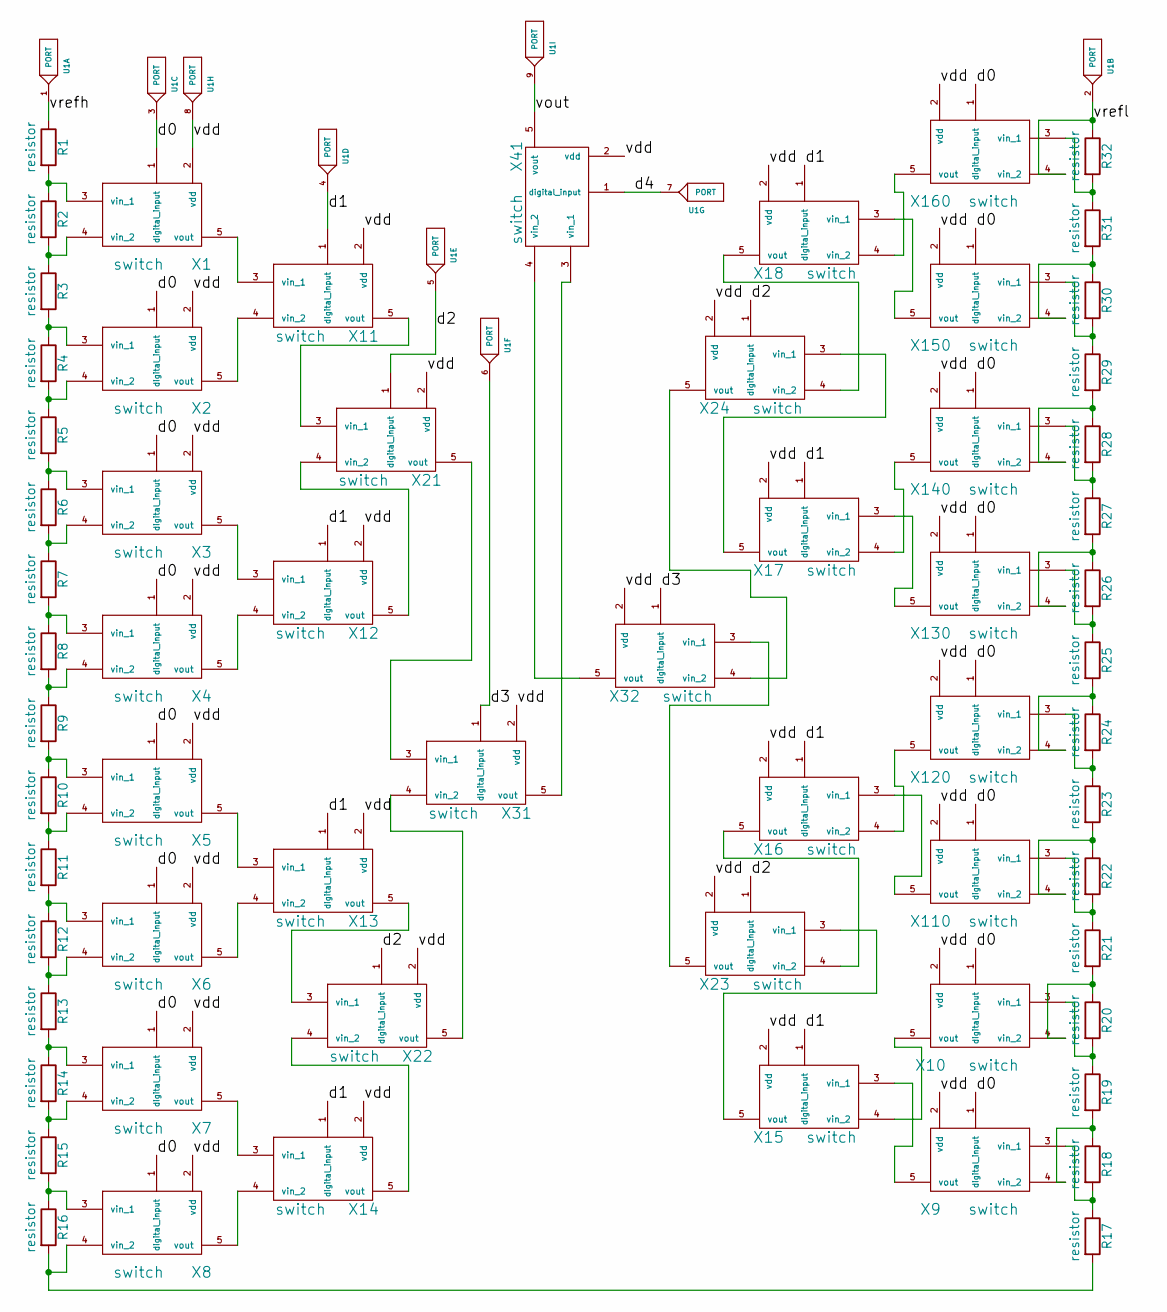
[picture p38: schematic 5bit_DACa.sch]

Parts:
R1, R2, R3, R4, R5, R6, R7, R8, R9, R10, R11, R12, R13, R14, R15, R16, R17, R18, R19, R20, R21, R22, R23, R24, R25, R26, R27, R28, R29, R30, R31, R32: resistor
U1: PORT
X1, X2, X3, X4, X5, X6, X7, X8, X9, X10, X11, X12, X13, X14, X15, X16, X17, X18, X21, X22, X23, X24, X31, X32, X41, X110, X120, X130, X140, X150, X160: switch

Connections:
unnamed: R1.2, R2.1, X1.3 (vin_1)
unnamed: R2.2, R3.1, X1.4 (vin_2)
unnamed: R3.2, R4.1, X2.3 (vin_1)
unnamed: R4.2, R5.1, X2.4 (vin_2)
unnamed: R5.2, R6.1, X3.3 (vin_1)
unnamed: R6.2, R7.1, X3.4 (vin_2)
unnamed: R7.2, R8.1, X4.3 (vin_1)
unnamed: R8.2, R9.1, X4.4 (vin_2)
unnamed: R9.2, R10.1, X5.3 (vin_1)
unnamed: R10.2, R11.1, X5.4 (vin_2)
unnamed: R11.2, R12.1, X6.3 (vin_1)
unnamed: R12.2, R13.1, X6.4 (vin_2)
unnamed: R13.2, R14.1, X7.3 (vin_1)
unnamed: R14.2, R15.1, X7.4 (vin_2)
unnamed: R15.2, R16.1, X8.3 (vin_1)
unnamed: R16.2, R17.2, X8.4 (vin_2)
unnamed: R17.1, R18.2, X9.3 (vin_1)
unnamed: R18.1, R19.2, X9.4 (vin_2)
unnamed: R19.1, R20.2, X10.3 (vin_1)
unnamed: R20.1, R21.2, X10.4 (vin_2)
unnamed: R21.1, R22.2, X110.3 (vin_1)
unnamed: R22.1, R23.2, X110.4 (vin_2)
unnamed: R23.1, R24.2, X120.3 (vin_1)
unnamed: R24.1, R25.2, X120.4 (vin_2)
unnamed: R25.1, R26.2, X130.3 (vin_1)
unnamed: R26.1, R27.2, X130.4 (vin_2)
unnamed: R27.1, R28.2, X140.3 (vin_1)
unnamed: R28.1, R29.2, X140.4 (vin_2)
unnamed: R29.1, R30.2, X150.3 (vin_1)
unnamed: R30.1, R31.2, X150.4 (vin_2)
unnamed: R31.1, R32.2, X160.3 (vin_1)
unnamed: X1.5 (vout), X11.3 (vin_1)
unnamed: X10.5 (vout), X15.4 (vin_2)
unnamed: X2.5 (vout), X11.4 (vin_2)
unnamed: X11.5 (vout), X21.3 (vin_1)
unnamed: X3.5 (vout), X12.3 (vin_1)
unnamed: X4.5 (vout), X12.4 (vin_2)
unnamed: X12.5 (vout), X21.4 (vin_2)
unnamed: X5.5 (vout), X13.3 (vin_1)
unnamed: X6.5 (vout), X13.4 (vin_2)
unnamed: X13.5 (vout), X22.3 (vin_1)
unnamed: X7.5 (vout), X14.3 (vin_1)
unnamed: X8.5 (vout), X14.4 (vin_2)
unnamed: X14.5 (vout), X22.4 (vin_2)
unnamed: X9.5 (vout), X15.3 (vin_1)
unnamed: X15.5 (vout), X23.3 (vin_1)
unnamed: X16.5 (vout), X23.4 (vin_2)
unnamed: X17.5 (vout), X24.3 (vin_1)
unnamed: X18.5 (vout), X24.4 (vin_2)
unnamed: X21.5 (vout), X31.3 (vin_1)
unnamed: X22.5 (vout), X31.4 (vin_2)
unnamed: X23.5 (vout), X32.3 (vin_1)
unnamed: X24.5 (vout), X32.4 (vin_2)
unnamed: X31.5 (vout), X41.3 (vin_1)
unnamed: X32.5 (vout), X41.4 (vin_2)
unnamed: X16.3 (vin_1), X110.5 (vout)
unnamed: X16.4 (vin_2), X120.5 (vout)
unnamed: X17.3 (vin_1), X130.5 (vout)
unnamed: X17.4 (vin_2), X140.5 (vout)
unnamed: X18.3 (vin_1), X150.5 (vout)
unnamed: X18.4 (vin_2), X160.5 (vout)
d0: U1.3, X1.1 (digital_input), X2.1 (digital_input), X3.1 (digital_input), X4.1 (digital_input), X5.1 (digital_input), X6.1 (digital_input), X7.1 (digital_input), X8.1 (digital_input), X9.1 (digital_input), X10.1 (digital_input), X110.1 (digital_input), X120.1 (digital_input), X130.1 (digital_input), X140.1 (digital_input), X150.1 (digital_input), X160.1 (digital_input)
d1: U1.4, X11.1 (digital_input), X12.1 (digital_input), X13.1 (digital_input), X14.1 (digital_input), X15.1 (digital_input), X16.1 (digital_input), X17.1 (digital_input), X18.1 (digital_input)
d2: U1.5, X21.1 (digital_input), X22.1 (digital_input), X23.1 (digital_input), X24.1 (digital_input)
d3: U1.6, X31.1 (digital_input), X32.1 (digital_input)
d4: U1.7, X41.1 (digital_input)
vdd: U1.8, X1.2 (vdd), X2.2 (vdd), X3.2 (vdd), X4.2 (vdd), X5.2 (vdd), X6.2 (vdd), X7.2 (vdd), X8.2 (vdd), X9.2 (vdd), X10.2 (vdd), X11.2 (vdd), X12.2 (vdd), X13.2 (vdd), X14.2 (vdd), X15.2 (vdd), X16.2 (vdd), X17.2 (vdd), X18.2 (vdd), X21.2 (vdd), X22.2 (vdd), X23.2 (vdd), X24.2 (vdd), X31.2 (vdd), X32.2 (vdd), X41.2 (vdd), X110.2 (vdd), X120.2 (vdd), X130.2 (vdd), X140.2 (vdd), X150.2 (vdd), X160.2 (vdd)
vout: U1.9, X41.5 (vout)
vrefh: R1.1, U1.1
vrefl: R32.1, U1.2, X160.4 (vin_2)
