vsdip/avsddac_3v3_sky130_v2/subcircuits/5bit_DACa/switch.sch

## KiCad design subcircuits/5bit_DACa/switch.sch (2021-03-26)

Schematic: switch.sch

Parts:
M1, M3, M4, M8: mosfet_n
M2, M5, M6, M7: mosfet_p
U1: PORT
