vsdip/avsddac_3v3_sky130_v2/subcircuits/9bit_DAC/2bit_DAC.sch

## KiCad design subcircuits/9bit_DAC/2bit_DAC.sch (2021-03-26)

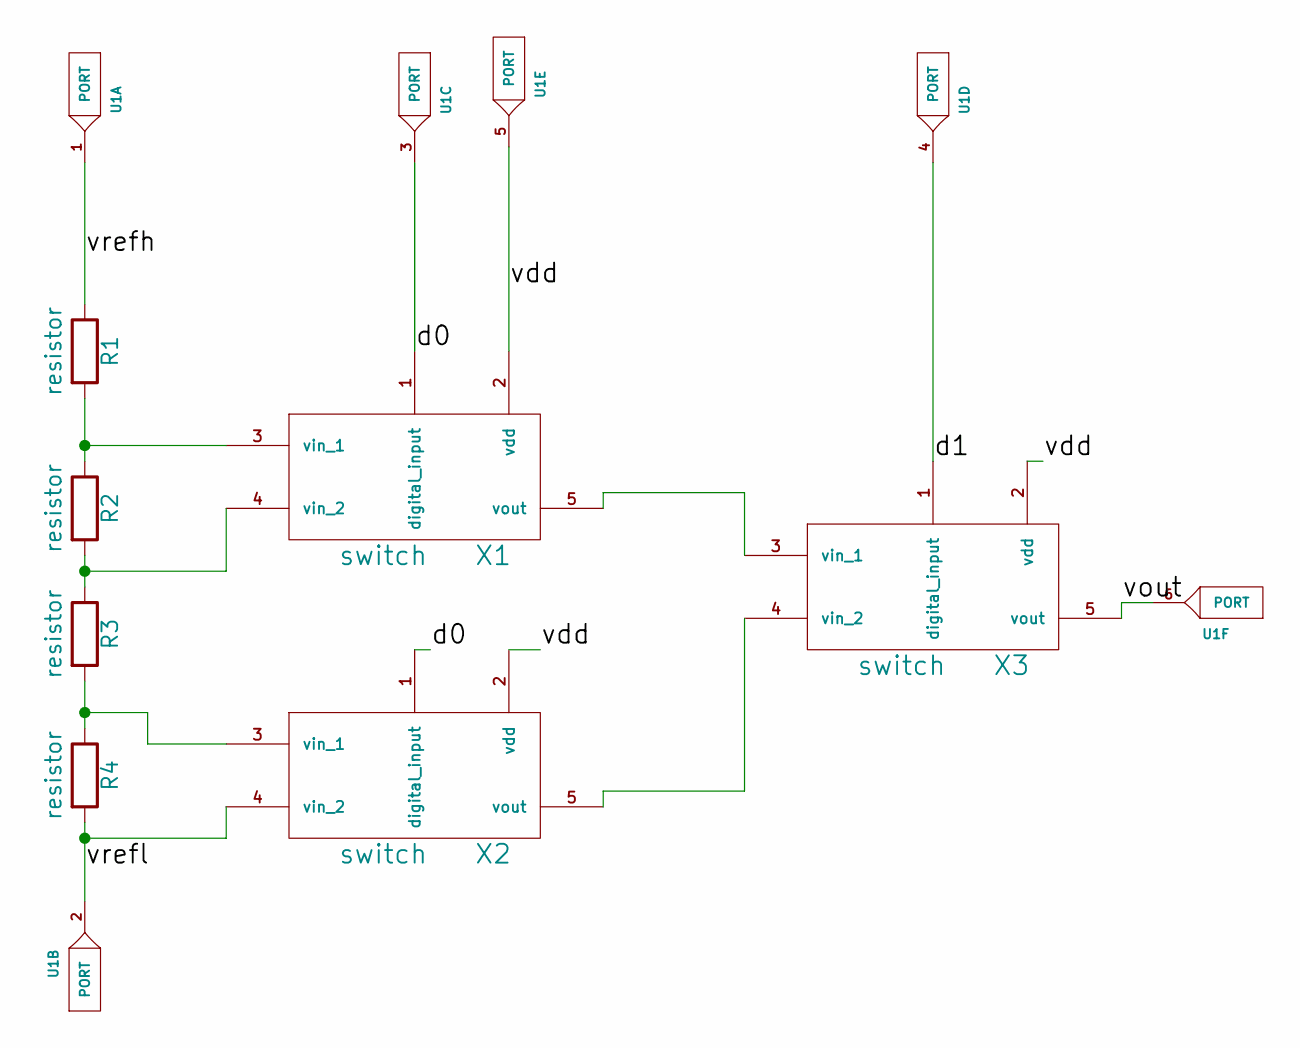
[picture p39: schematic 2bit_DAC.sch]

Parts:
R1, R2, R3, R4: resistor
U1: PORT
X1, X2, X3: switch

Connections:
unnamed: R1.2, R2.1, X1.3 (vin_1)
unnamed: R2.2, R3.1, X1.4 (vin_2)
unnamed: R3.2, R4.1, X2.3 (vin_1)
unnamed: X1.5 (vout), X3.3 (vin_1)
unnamed: X2.5 (vout), X3.4 (vin_2)
d0: U1.3, X1.1 (digital_input), X2.1 (digital_input)
d1: U1.4, X3.1 (digital_input)
vdd: U1.5, X1.2 (vdd), X2.2 (vdd), X3.2 (vdd)
vout: U1.6, X3.5 (vout)
vrefh: R1.1, U1.1
vrefl: R4.2, U1.2, X2.4 (vin_2)
