vsdip/avsddac_3v3_sky130_v2/subcircuits/9bit_DAC/6bit_DAC.sch

## KiCad design subcircuits/9bit_DAC/6bit_DAC.sch (2021-03-26)

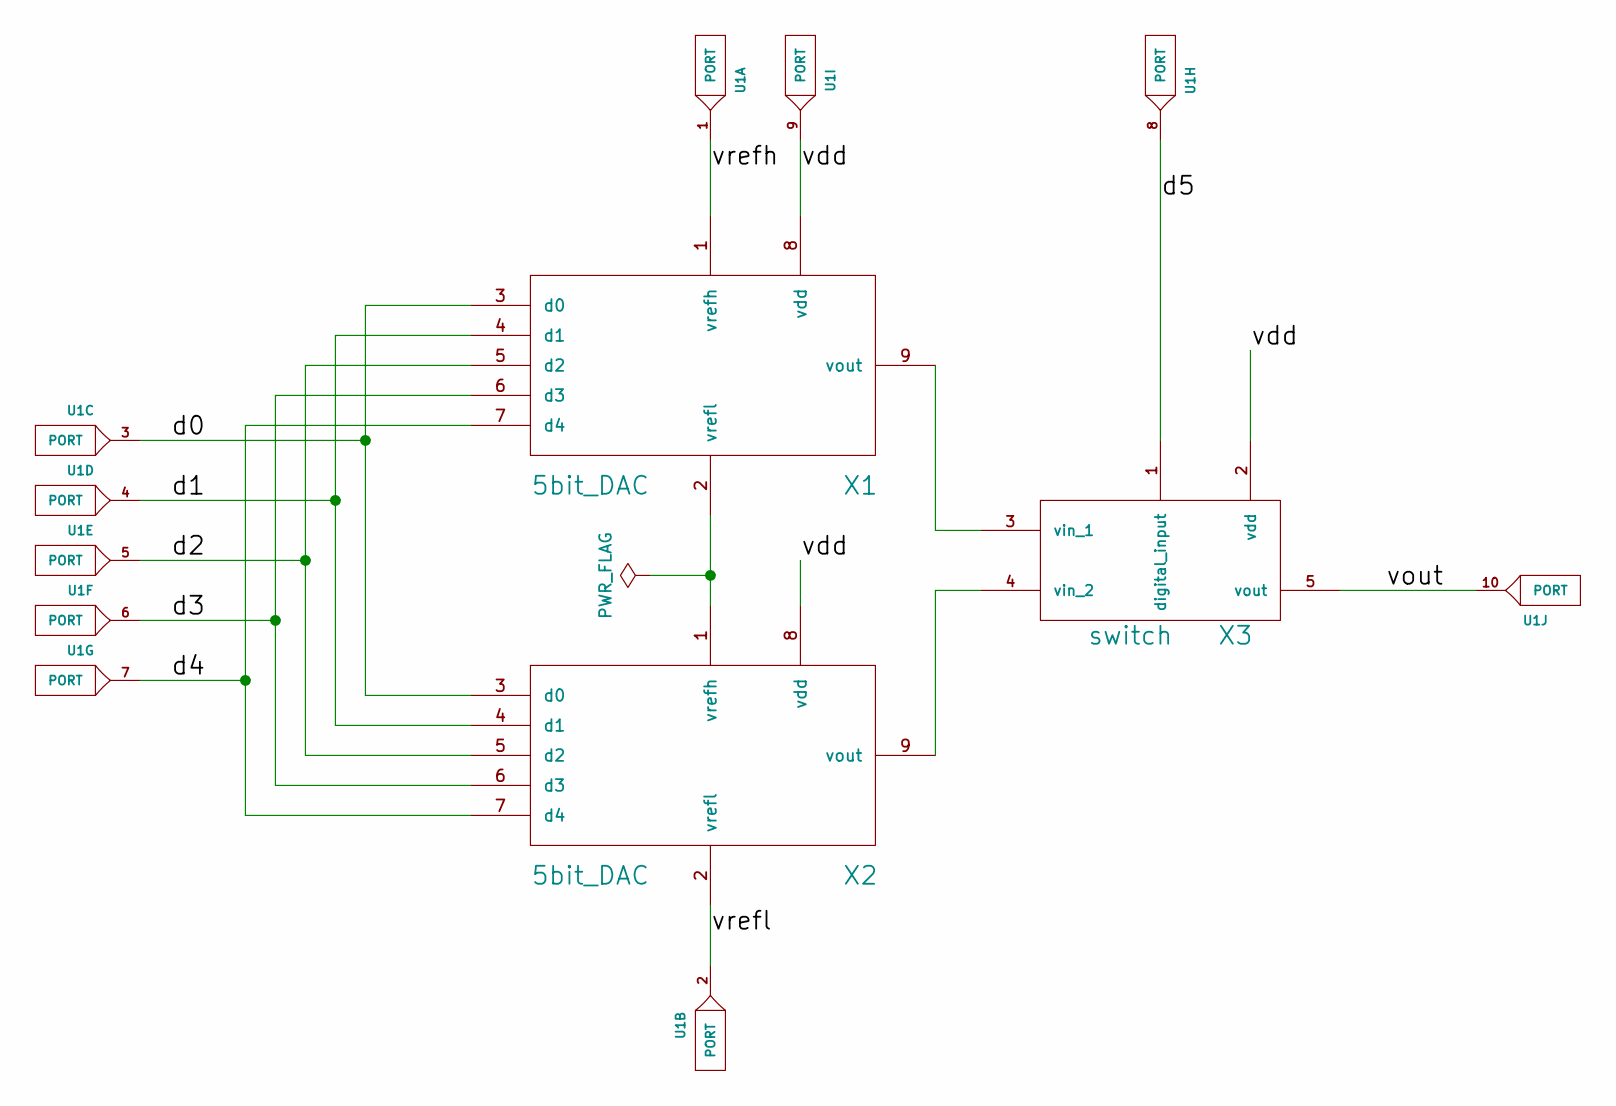
[picture p43: schematic 6bit_DAC.sch]

Parts:
U1: PORT
X1, X2: 5bit_DAC
X3: switch

Connections:
unnamed: X1.2 (vrefl), X2.1 (vrefh)
unnamed: X1.9 (vout), X3.3 (vin_1)
unnamed: X2.9 (vout), X3.4 (vin_2)
d0: U1.3, X1.3 (d0), X2.3 (d0)
d1: U1.4, X1.4 (d1), X2.4 (d1)
d2: U1.5, X1.5 (d2), X2.5 (d2)
d3: U1.6, X1.6 (d3), X2.6 (d3)
d4: U1.7, X1.7 (d4), X2.7 (d4)
d5: U1.8, X3.1 (digital_input)
vdd: U1.9, X1.8 (vdd), X2.8 (vdd), X3.2 (vdd)
vout: U1.10, X3.5 (vout)
vrefh: U1.1, X1.1 (vrefh)
vrefl: U1.2, X2.2 (vrefl)
